Friedsam2000/Robotic-Arm-Prototype/README.md

Demo Video:

https://www.youtube.com/watch?v=VJjeDxEc2eg&ab_channel=Samuel
