Friedsam2000/Robotic-Arm-Prototype/Semester_Thesis_Tim_Heger_Final/100_Design_and_models/README.md

`100_Design_and_models` this folder is for models or CAD data
