Friedsam2000/Robotic-Arm-Prototype/Semester_Thesis_Tim_Heger_Final/900_Report/README.md

`900_Report`: folder with the LaTeX document for your final report

* You can compile and view the document using F5 / 'Compile and View' in TeXstudio
* See the actual template for examples and more details on how to use it
* `clean.bat` : deletes all auxiliary and temporary files (recursively); also deletes all pdf documents _in the current folder only_

Edit the `setup/metadata.tex` file to customise your name, thesis title, date etc.

Second-level structure:
* `images` store images and figures here
* `tikz` put your TikZ files in this folder
* `setup` here are the configuration files
* `chapters` here are the `*.tex` files of the report itself
* `auxfiles` auxiliary stuff is stored here
* `attachments` (optional) here are the attachments
* `sources` (optional) here are the sources of your listings
* `bibtex` put the BibTeX file here
