Friedsam2000/Robotic-Arm-Prototype/Semester_Thesis_Tim_Heger_Final/900_Report/auxfiles/acknowledgments.tex

The robotic arm also consists of other things. Such as joy and laughter. It is a robotic arm with joyful conciousness! Sometimes, in the morning, before anyone is there, the robotic arm 
quietly makes a mental gratitude list. For instance, it is grateful that it now exists! And it is grateful to be described in this paper.
Thus, the robotic arm is made up of a lot of different parts, all equally important!
