Friedsam2000/Robotic-Arm-Prototype/Semester_Thesis_Tim_Heger_Final/900_Report/images/__titlePage/logo-mor.tex

\node[anchor = center, opacity = 0.2] at ([yshift = 6 cm, xshift = 12.5 cm] current page.south west)
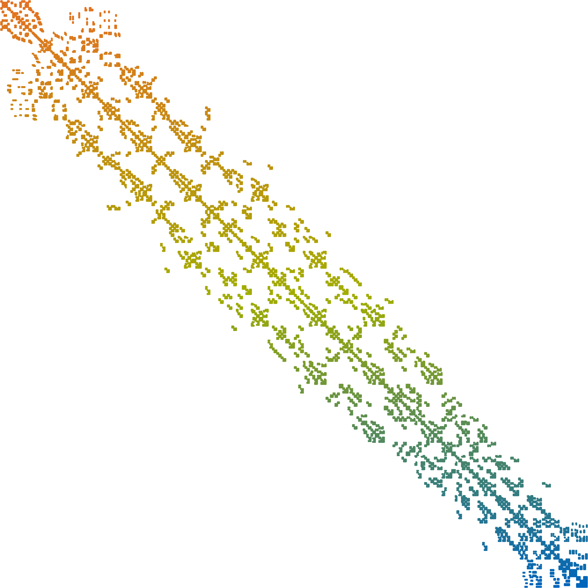
[picture p23: Semester_Thesis_Tim_Heger_Final/900_Report/images/__titlePage/logo-mor.png]
    {};
