Friedsam2000/Robotic-Arm-Prototype/Semester_Thesis_Tim_Heger_Final/900_Report/images/__titlePage/logo-mpc.tex

\node[anchor = center, opacity = 0.2] at ([yshift = 3 cm, xshift = 10.5 cm] current page.south west)
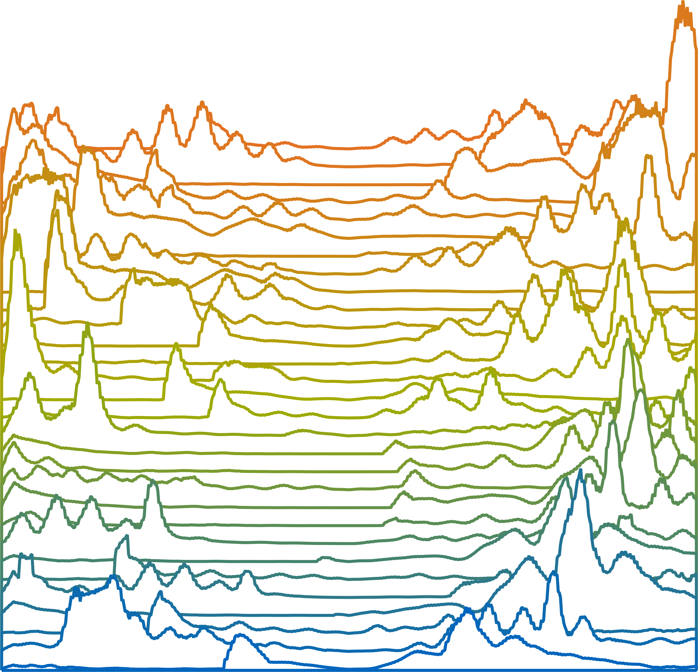
[picture p24: Semester_Thesis_Tim_Heger_Final/900_Report/images/__titlePage/logo-mpc.png]
    {};
