Friedsam2000/Robotic-Arm-Prototype/Semester_Thesis_Tim_Heger_Final/020_Presentations/main.pdf

Lehrstuhl für Regelungstechnik School of Engineering and Design Technische Universität München

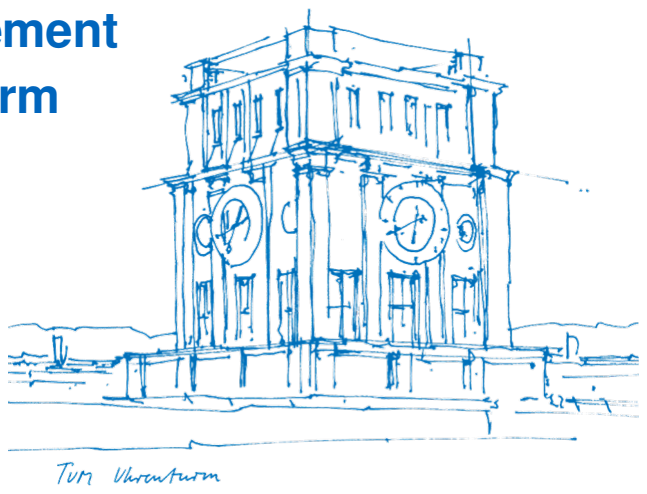
[picture p46: figure]

# Development and Enhancement of a Lightweight Robotic Arm

## with Torque Control Exploration

## Tim Heger

Lehrstuhl für Regelungstechnik School of Engineering and Design Technische Universität München

## 3. Dezember 2025

# Outline

1 | Einführung
2 | Hardware Verbesserungen
3 | Drehmomentmessung
4 | Drehmomentbasierte Regelung
Tim Heger | Development and Enhancementof a Lightweight Robotic Arm | 03/12/2025 | 1

# Einführung

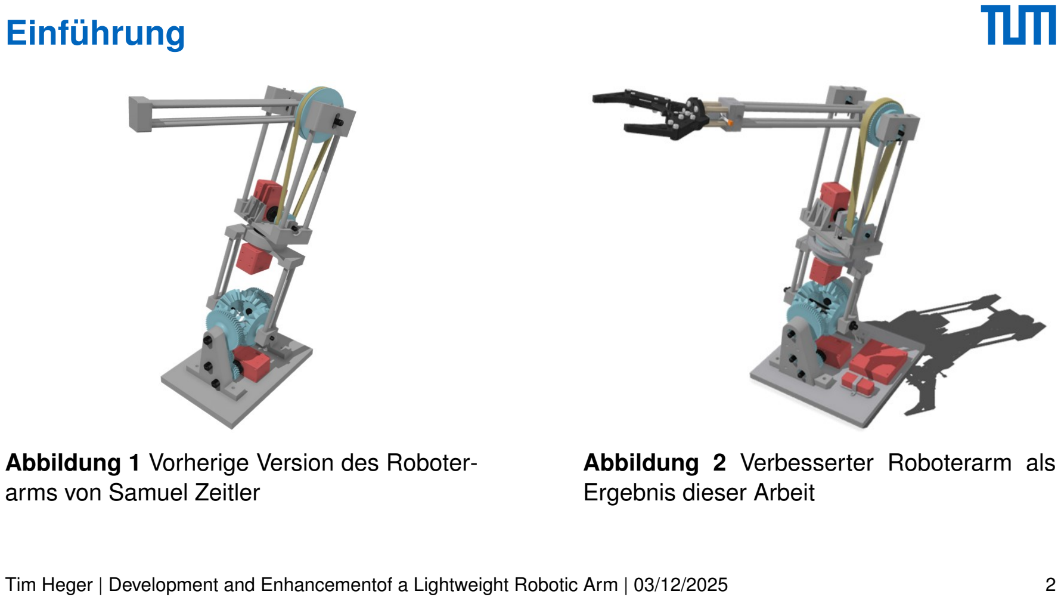
[picture p47: page 3]

### Abbildung 1 Vorherige Version des Roboterarms von Samuel Zeitler

### Abbildung 2 Verbesserter Roboterarm als Ergebnis dieser Arbeit

Tim Heger | Development and Enhancementof a Lightweight Robotic Arm | 03/12/2025 | 2

# Outline

1 | Einführung
2 | Hardware Verbesserungen
3 | Drehmomentmessung
4 | Drehmomentbasierte Regelung
Tim Heger | Development and Enhancementof a Lightweight Robotic Arm | 03/12/2025 | 2

# Hardware Verbesserungen

## Mechanische Verstärkungen

## ■ Achsen aus Aluminium gedreht

## ■ Kugellager hinzugefügt

## ■ Basis und Seitenstreben aus Aluminium gefräst


### Abbildung 3 Beispielhafte Ansicht der Hardwareverbesserungen am Schultergelenk

Tim Heger | Development and Enhancementof a Lightweight Robotic Arm | 03/12/2025 | 3

# Hardware Verbesserungen

## Planetengetriebe

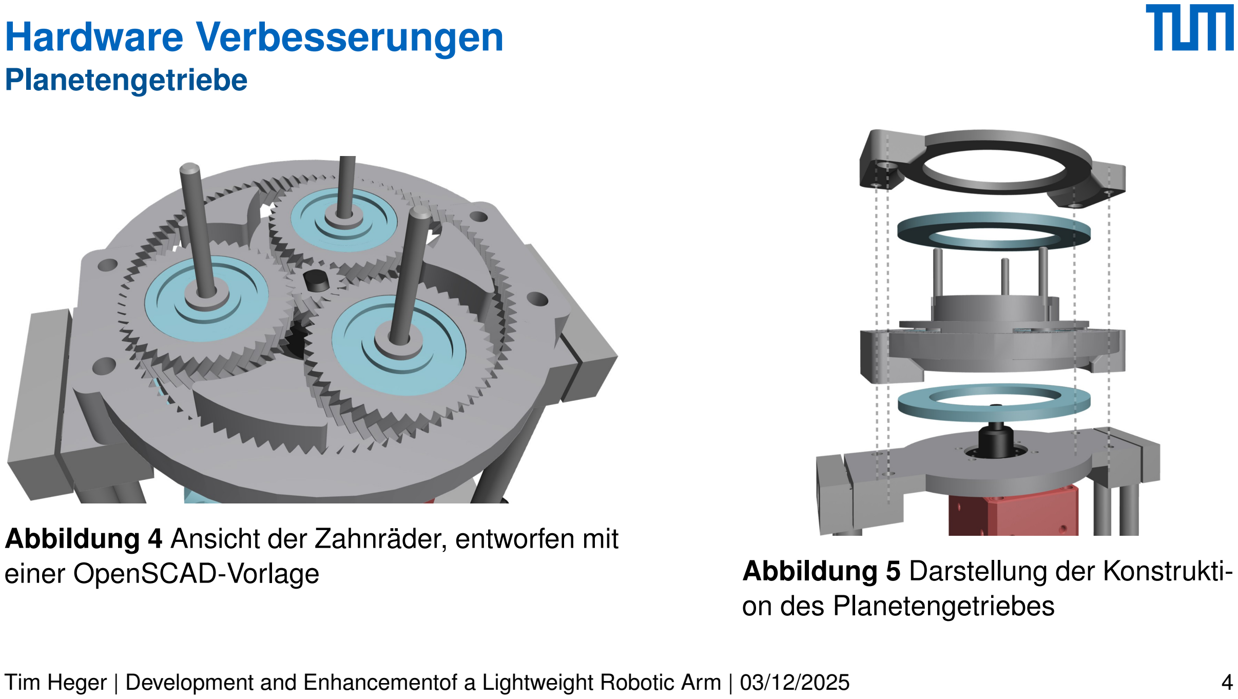
[picture p48: page 6]

### Abbildung 4 Ansicht der Zahnräder, entworfen mit

einer OpenSCAD-Vorlage | Abbildung 5 Darstellung der Konstrukti- on des Planetengetriebes
Tim Heger | Development and Enhancementof a Lightweight Robotic Arm | 03/12/2025 | 4

# Hardware Verbesserungen

## Endeffektor


### Abbildung 6 Greifhand mit zwei Fingern als Endeffektor

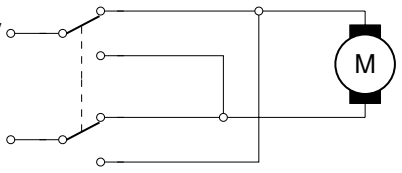
[picture p49: figure]

5V

## GND

### Abbildung 7 Shaltbild des Anschlusses der Greifhand

Tim Heger | Development and Enhancementof a Lightweight Robotic Arm | 03/12/2025 | 5

# Outline

1 | Einführung
2 | Hardware Verbesserungen
3 | Drehmomentmessung
4 | Drehmomentbasierte Regelung
Tim Heger | Development and Enhancementof a Lightweight Robotic Arm | 03/12/2025 | 5

# Drehmomentmessung

## Expreimentaufbau


### Abbildung 8 Experimentaufbau zur Drehmomentmessung der Motoren

Tim Heger | Development and Enhancementof a Lightweight Robotic Arm | 03/12/2025 | 6

# Drehmomentmessung

## Einteilung in drei Betriebsarten


Abbildung 9 Experiment zur Feststellung der drei Betriebsarten: Entgegenwirkender Moment, Still-

### stand, und mitwirkender Moment

Tim Heger | Development and Enhancementof a Lightweight Robotic Arm | 03/12/2025 | 7

# Drehmomentmessung

## Ergebnisse


Abbildung 10 Ergebnisse der Drehmomentmessung: zwei Kennlinien für die zwei dynamischen Be-

### triebsarten

Tim Heger | Development and Enhancementof a Lightweight Robotic Arm | 03/12/2025 | 8

# Drehmomentmessung

## Implementierung einer Kräftemessung

F = (J

T
)
+ τ | (1)

## Gesucht: Kraftvektor F Gegeben: Jacobi-Matrix J Gemessen: Drehmomentvektor der Gelenke τ

## Demonstration

Tim Heger | Development and Enhancementof a Lightweight Robotic Arm | 03/12/2025 | 9

# Outline

1 | Einführung
2 | Hardware Verbesserungen
3 | Drehmomentmessung
4 | Drehmomentbasierte Regelung
Tim Heger | Development and Enhancementof a Lightweight Robotic Arm | 03/12/2025 | 9

# Drehmomentbasierte Regelung

## PD-Regler im Gelenkraum

τtarget = −Kp ∆q − Kd q˙current | (2)

## Gesucht: Drehmomentvektor der Gelenke τtarget Gegeben: Proportional- und Differentialverstärkung Kp und Kd Gemessen: Gelenkpositionsfehler ∆q und Gelenkgeschwindigkeitsvektor q˙current

## Demonstration

Tim Heger | Development and Enhancementof a Lightweight Robotic Arm | 03/12/2025 | 10

# Drehmomentbasierte Regelung

## PD-Regler im Kartesischen Raum

Ftarget = −Kp ∆x − Kd

xcurrent − xprevious
∆t
| | {z | }
| x˙

(3)

τtarget = J

T Ftarget
| | {z | }
τtask

+ knull N

∂H
∂q
| | {z | }
τnull

(4)

## Gesucht: Drehmomentvektor der Gelenke τtarget Gegeben: Kp und Kd, Jacobi-Matrix J, Nullraumverstärkung knull Errechnet: Nullraumprojektion N und Kostenfunktion ∂H

∂q

## Gemessen: TCP-Positionen ∆x, xcurrent und xprevious, zeitintervall ∆t

Tim Heger | Development and Enhancementof a Lightweight Robotic Arm | 03/12/2025 | 11

# Drehmomentbasierte Regelung

## Krafterzeugung

Ftarget = Fpd + Fdes | (5)
Fpd = −Kp ∆xline − Kd ∆ ˙xline | (6)

## Gesucht: TCP-Kräfte Ftarget Gegeben: Kp und Kd, zu erzeugende Kraft Fdes Errechnet: Distanz zur durch Ftarget aufgespannten Linie ∆xline und ∆ ˙xline Gemessen: TCP-Positionen zur Berechnung von ∆xline und ∆ ˙xline

## Demonstration

Tim Heger | Development and Enhancementof a Lightweight Robotic Arm | 03/12/2025 | 12

# Vielen Dank für Ihre Aufmerksamkeit!

# Haben Sie noch Fragen? Oder Anregungen für zukünftige Arbeiten?

Tim Heger | Development and Enhancementof a Lightweight Robotic Arm | 03/12/2025 | 13

# Anhang

## Berechnung der Nullraumprojektion und Kostenfunktion

## N = I − J

T

## J JT + λ

2
damp I

−1
J | (7)

## Gesucht: Nullraumprojektion N Gegeben: Dämpfungsfaktor λdamp, Einheitsmatrix I, Jacobi-Matrix J

∂H

## ∂q = diag

1
q

2
max

| | {z | }
Gewichtsmatrix W
(q − qdes) | (8)

## Gesucht: Ableitung der Kostenfunktion ∂H

∂q

## Gegeben: gewünschte Gelenkposition qdes, maximale Gelenkposition qmax Gemessen: aktuelle Gelenkposition q

Tim Heger | Development and Enhancementof a Lightweight Robotic Arm | 03/12/2025 | 14

# Anhang

## Berechnung der Distanz zur Kraftlinie

∆xline = ∆x −

(∆x · Fdes)

## norm(Fdes)

2

- Fdes | (9)

∆ ˙xline =

∆xline,curr − ∆xline,prev
∆t

(10)

## Gesucht: Distanz zur Kraftlinie ∆xline und ∆ ˙xline Gegeben: gewünschte Kraft Fdes Gemessen: TCP-Positionen zur Berechnung von ∆x, Zeitintervall ∆t

Tim Heger | Development and Enhancementof a Lightweight Robotic Arm | 03/12/2025 | 15
