Friedsam2000/Robotic-Arm-Prototype/Semester_Thesis_Tim_Heger_Final/900_Report/auxfiles/__backMatter.tex

% ==================================================================
% Appendices and back matter
% ==================================================================
\appendix

\include{auxfiles/notation}

\renewcommand{\listtheoremname}{\nameLoTheorems}
\listoftheorems
\addcontentsline{toc}{chapter}{\nameLoTheorems}

\renewcommand{\listalgorithmcfname}{\nameLoAlgorithms}
\listofalgorithms
\addcontentsline{toc}{chapter}{\nameLoAlgorithms}

\renewcommand{\listfigurename}{\nameLoFigures}
\listoffigures
\addcontentsline{toc}{chapter}{\nameLoFigures}

\renewcommand{\listtablename}{\nameLoTables}
\listoftables
\addcontentsline{toc}{chapter}{\nameLoTables}

\renewcommand{\lstlistlistingname}{\nameLoListings}
\lstlistoflistings
\addcontentsline{toc}{chapter}{\nameLoListings}

\printbibliography[title=\nameCaReferences]
\addcontentsline{toc}{chapter}{\nameCaReferences}

% ==================================================================
