Friedsam2000/Robotic-Arm-Prototype/Semester_Thesis_Tim_Heger_Final/900_Report/auxfiles/abbreviationsAndAcronyms.tex

% ======================================================================
% Declare acronyms
% ======================================================================
\DeclareAcronym{LQR}{
  short = LQR,
  long = linear quadratic regulator
}

\DeclareAcronym{LMS}{
  short = LMS,
  long = least mean squares
}

\DeclareAcronym{MPC}{
  short = MPC,
  long = model predictive control
}

\DeclareAcronym{MSE}{
  short = MSE,
  long = mean-square error
}

\DeclareAcronym{DAE}{
  short = DAE,
  long = differential algebraic equation
}

\DeclareAcronym{ODE}{
  short = ODE,
  long = ordinary differential equation
}

\DeclareAcronym{PDE}{
  short = PDE,
  long = partial differential equation
}

\DeclareAcronym{EKF}{
  short = EKF,
  long = extended Kalman filter
}

\DeclareAcronym{LP}{
  short = LP,
  long = linear program
}

\DeclareAcronym{MHE}{
  short = MHE,
  long = moving horizon estimation
}

\DeclareAcronym{MRAC}{
  short = MRAC,
  long = model reference adaptive control
}

\DeclareAcronym{NMPC}{
  short = NMPC,
  long = nonlinear model predictive control
}

\DeclareAcronym{OCP}{
  short = OCP,
  long = optimal control problem
}

\DeclareAcronym{QP}{
  short = QP,
  long = quadratic program
}

\DeclareAcronym{RHC}{
  short = RHC,
  long = receding horizon control
}

\DeclareAcronym{SDP}{
  short = SDP,
  long = semidefinite programming
}
% ======================================================================
