Friedsam2000/Robotic-Arm-Prototype/Semester_Thesis_Tim_Heger_Final/900_Report/auxfiles/abstractDE.tex

Bitte hier die Kurzfassung auf Deutsch hinzufügen:
\verb|./auxfiles/abstractDE.tex|
