Friedsam2000/Robotic-Arm-Prototype/Semester_Thesis_Tim_Heger_Final/100_Design_and_models/visualisation/planetary_gearbox_explosion.png

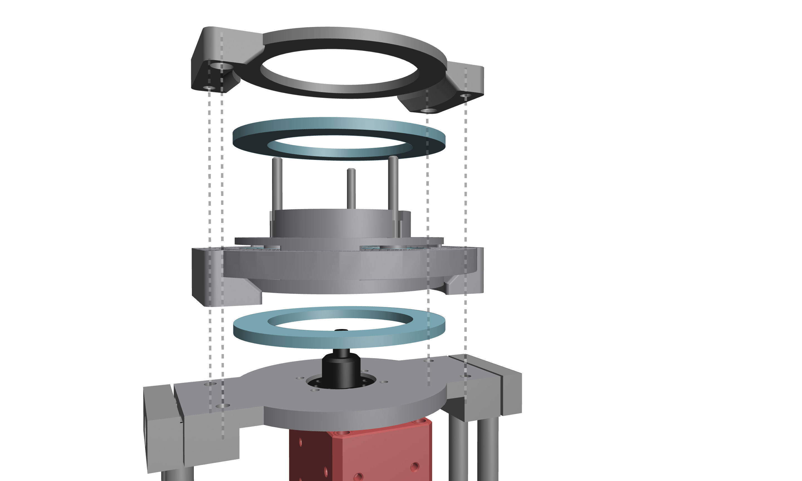
Semester_Thesis_Tim_Heger_Final/100_Design_and_models/visualisation/planetary_gearbox_explosion.png
