Friedsam2000/Robotic-Arm-Prototype/Semester_Thesis_Tim_Heger_Final/100_Design_and_models/visualisation/robot_arm_final.png

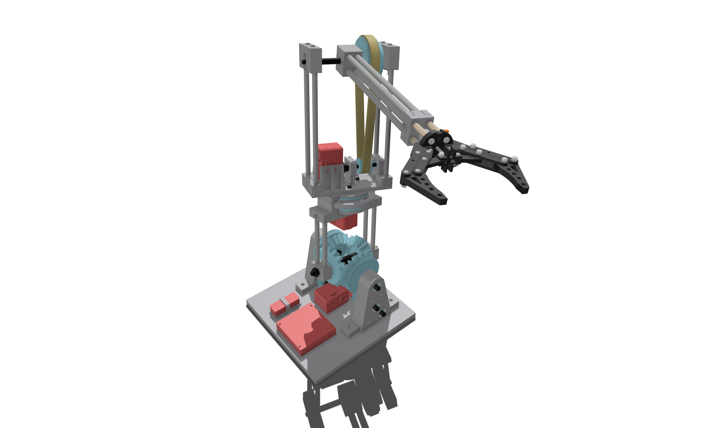
Semester_Thesis_Tim_Heger_Final/100_Design_and_models/visualisation/robot_arm_final.png
