Friedsam2000/Robotic-Arm-Prototype/Semester_Thesis_Tim_Heger_Final/900_Report/images/robot_arm_final_v3.jpg

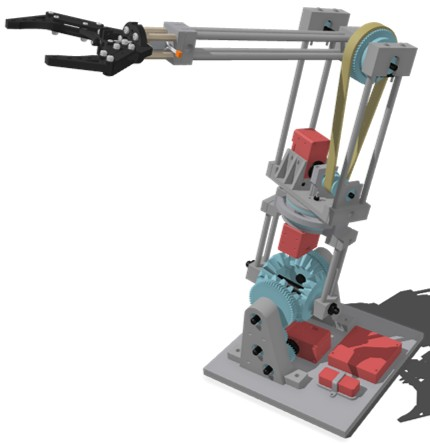
Semester_Thesis_Tim_Heger_Final/900_Report/images/robot_arm_final_v3.jpg
