Friedsam2000/Robotic-Arm-Prototype/UML_Diagram/UML_Diagram.png

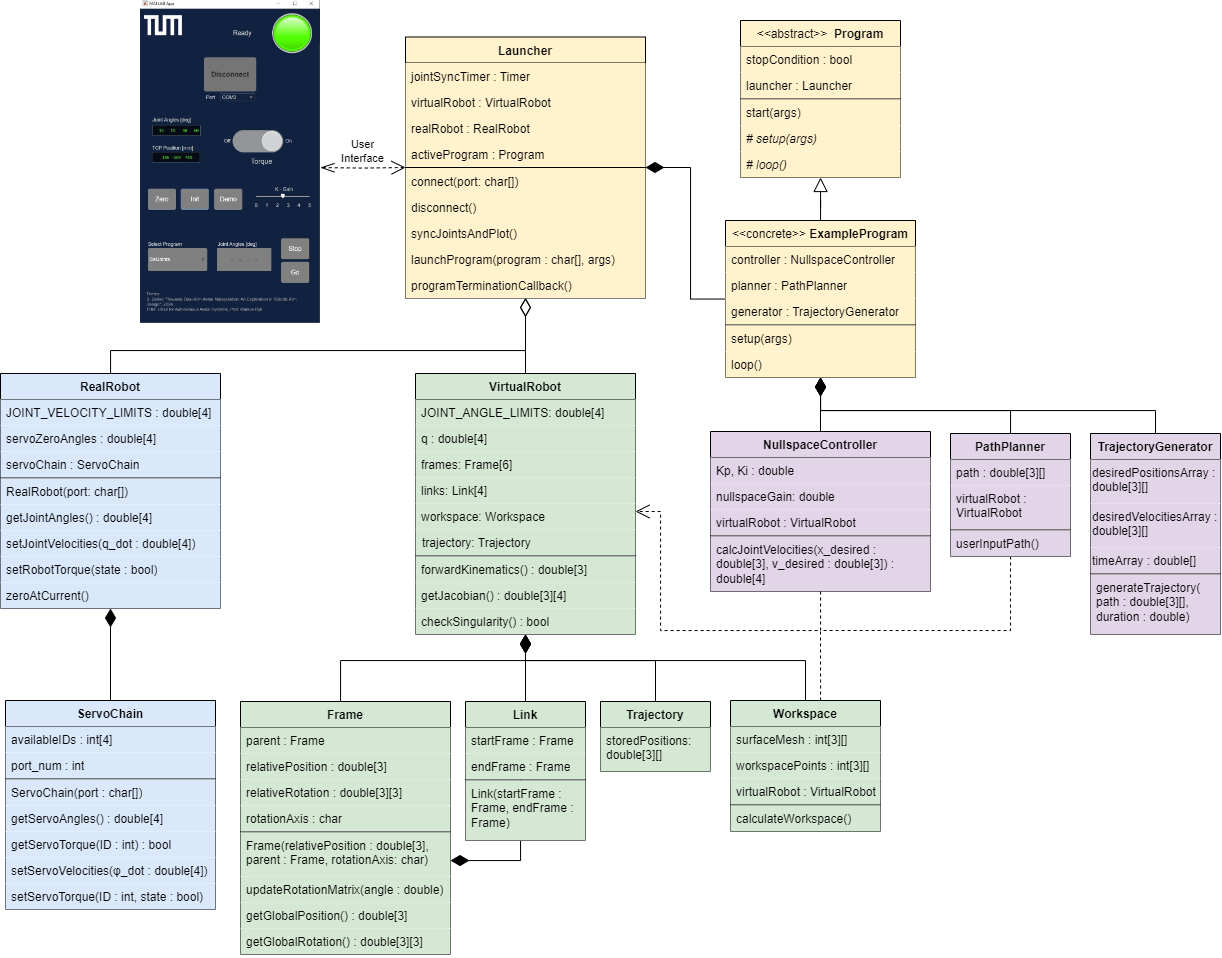
UML_Diagram/UML_Diagram.png
