Friedsam2000/Robotic-Arm-Prototype/Semester_Thesis_Tim_Heger_Final/100_Design_and_models/upper_segment/printing/_part_list.txt

1x upper_segment_base
2x upper_segment_base_clamp
2x ball_bearing_brace
2x tentioner_tube
2x tensioner_tube_holder
1x tube_endeffector1
1x tube_endeffector2
1x endeffector_plate
1x endeffector_brace1
1x endeffector_brace2
