Friedsam2000/Robotic-Arm-Prototype/Master_Thesis_Samuel_Zeitler_Final/CAD/shoulder_parts/turning/_part_list.txt

bevel_shaft x1
middle_shaft x2
motor_shaft x2
top_shaft x2
