Friedsam2000/Robotic-Arm-Prototype/Semester_Thesis_Tim_Heger_Final/100_Design_and_models/lower_segment/print2-turning/printing/_part_list.txt

connector_brace x1
connector_brace_tubes x2
gear_ring_v2 x1
gearbox_lid x1
planetary_axis_top x1
side_brace_torque_wheel x1
sun_gear_v2 x1
