Friedsam2000/Robotic-Arm-Prototype/Master_Thesis_Samuel_Zeitler_Final/CAD/shoulder_parts/printing/spacing_ring_bevel.stl

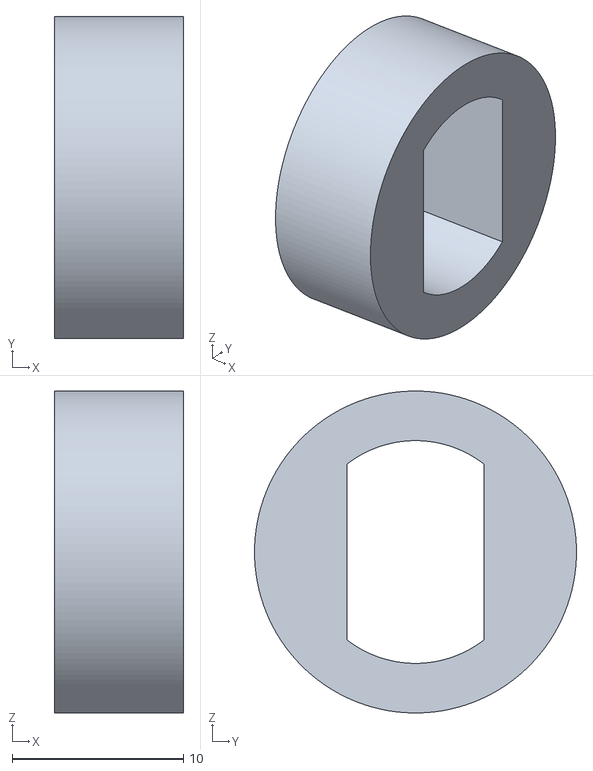
[picture p57: CAD file, 2025-12-09]
Master_Thesis_Samuel_Zeitler_Final/CAD/shoulder_parts/printing/spacing_ring_bevel.stl
7.53 x 18.8 x 18.8
