Friedsam2000/Robotic-Arm-Prototype/Master_Thesis_Samuel_Zeitler_Final/CAD/shoulder_parts/turning/middle_shaft.step

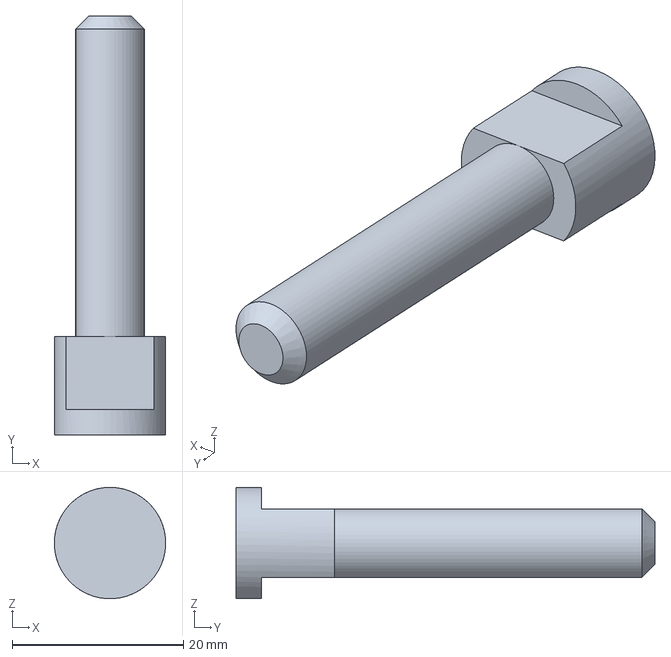
[picture p58: CAD file, 2025-05-21]
Master_Thesis_Samuel_Zeitler_Final/CAD/shoulder_parts/turning/middle_shaft.step
13.0 x 48.9 x 13.0 mm
