Friedsam2000/Robotic-Arm-Prototype/Semester_Thesis_Tim_Heger_Final/100_Design_and_models/ground_segment/milling/Side_Brace.step

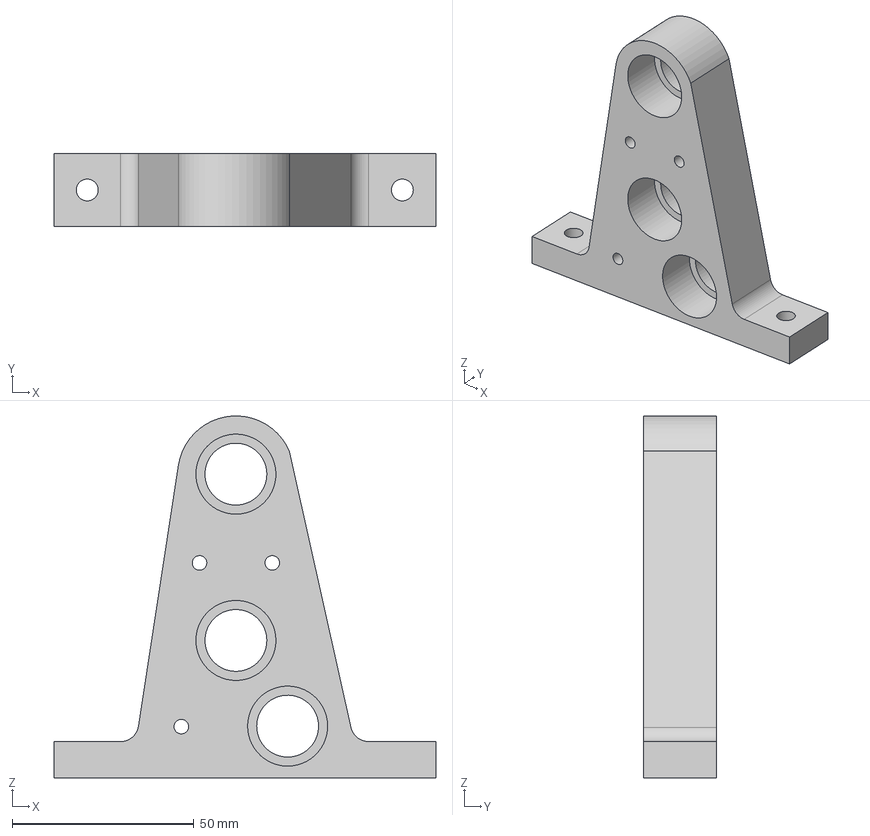
[picture p59: CAD file, 2025-12-09]
Semester_Thesis_Tim_Heger_Final/100_Design_and_models/ground_segment/milling/Side_Brace.step
105.0 x 20.0 x 99.5 mm
