Friedsam2000/Robotic-Arm-Prototype/Semester_Thesis_Tim_Heger_Final/100_Design_and_models/ground_segment/printing/torque_wheel.stl

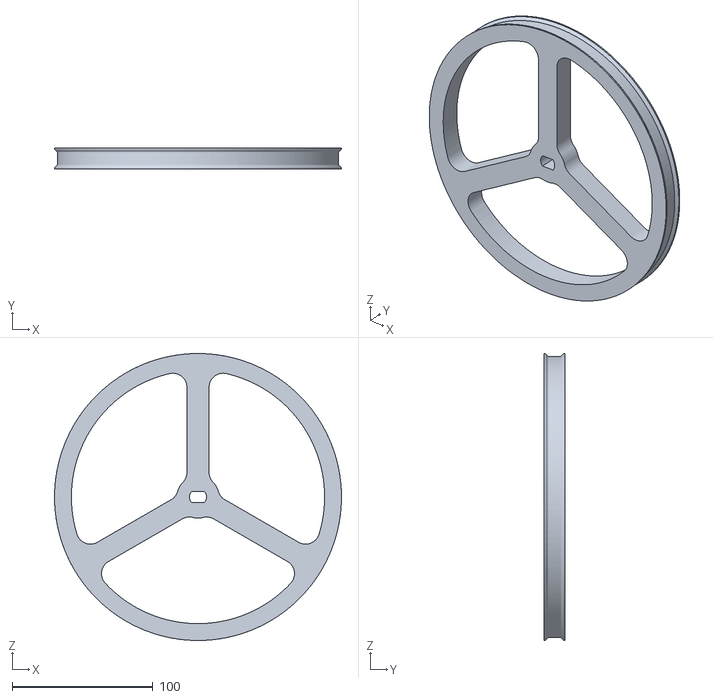
[picture p60: CAD file, 2025-12-09]
Semester_Thesis_Tim_Heger_Final/100_Design_and_models/ground_segment/printing/torque_wheel.stl
204.0 x 15.0 x 204.0
