Friedsam2000/Robotic-Arm-Prototype/Semester_Thesis_Tim_Heger_Final/100_Design_and_models/ground_segment/turning/top_shaft.step

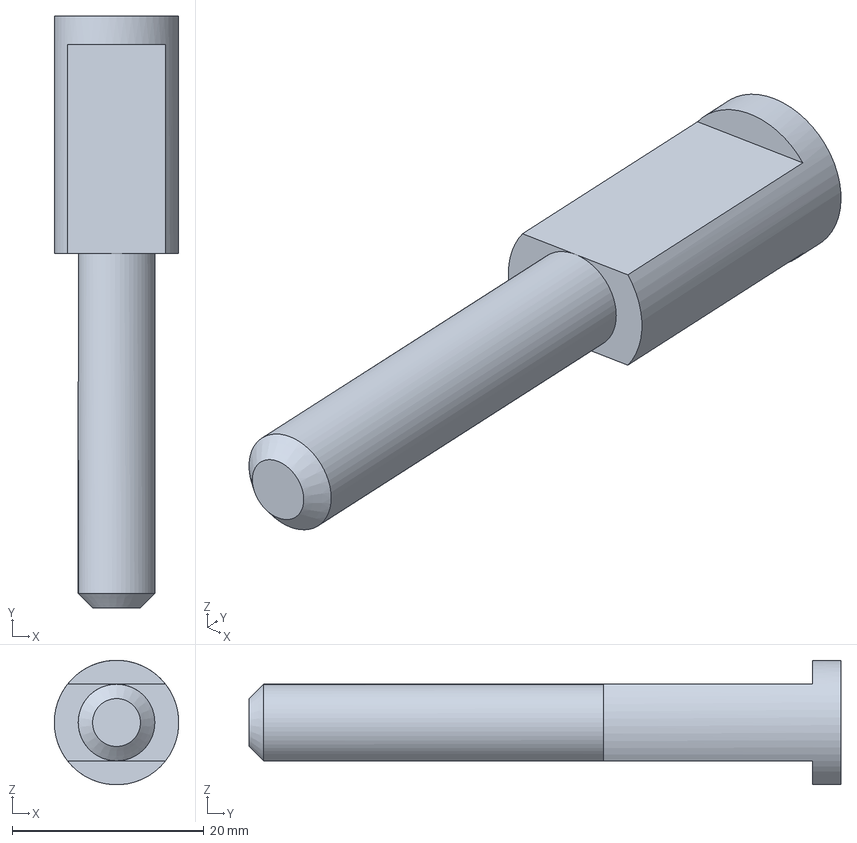
[picture p61: CAD file, 2025-05-21]
Semester_Thesis_Tim_Heger_Final/100_Design_and_models/ground_segment/turning/top_shaft.step
13.0 x 61.8 x 13.0 mm
