Friedsam2000/Robotic-Arm-Prototype/Semester_Thesis_Tim_Heger_Final/100_Design_and_models/lower_segment/print1/sun_gear.stl

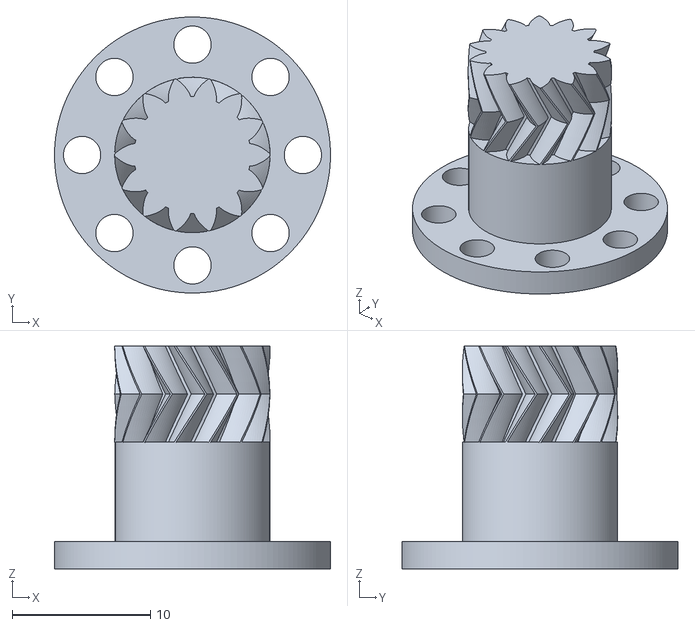
[picture p62: CAD file, 2025-12-09]
Semester_Thesis_Tim_Heger_Final/100_Design_and_models/lower_segment/print1/sun_gear.stl
20.0 x 20.0 x 16.2
