Friedsam2000/Robotic-Arm-Prototype/Semester_Thesis_Tim_Heger_Final/100_Design_and_models/lower_segment/print2-turning/printing/connector_brace.stl

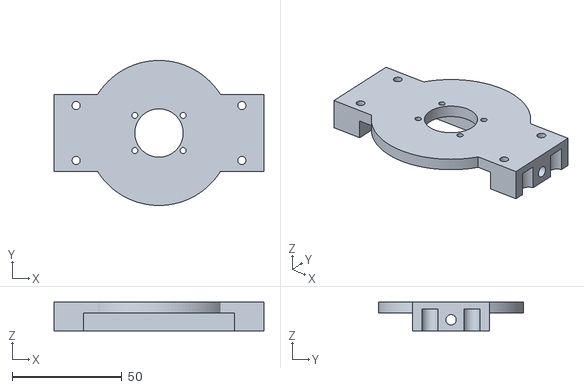
[picture p63: CAD file, 2025-12-09]
Semester_Thesis_Tim_Heger_Final/100_Design_and_models/lower_segment/print2-turning/printing/connector_brace.stl
95.6 x 66.0 x 13.0
