Friedsam2000/Robotic-Arm-Prototype/Semester_Thesis_Tim_Heger_Final/100_Design_and_models/lower_segment/print2-turning/turning/Motor_Axis.step

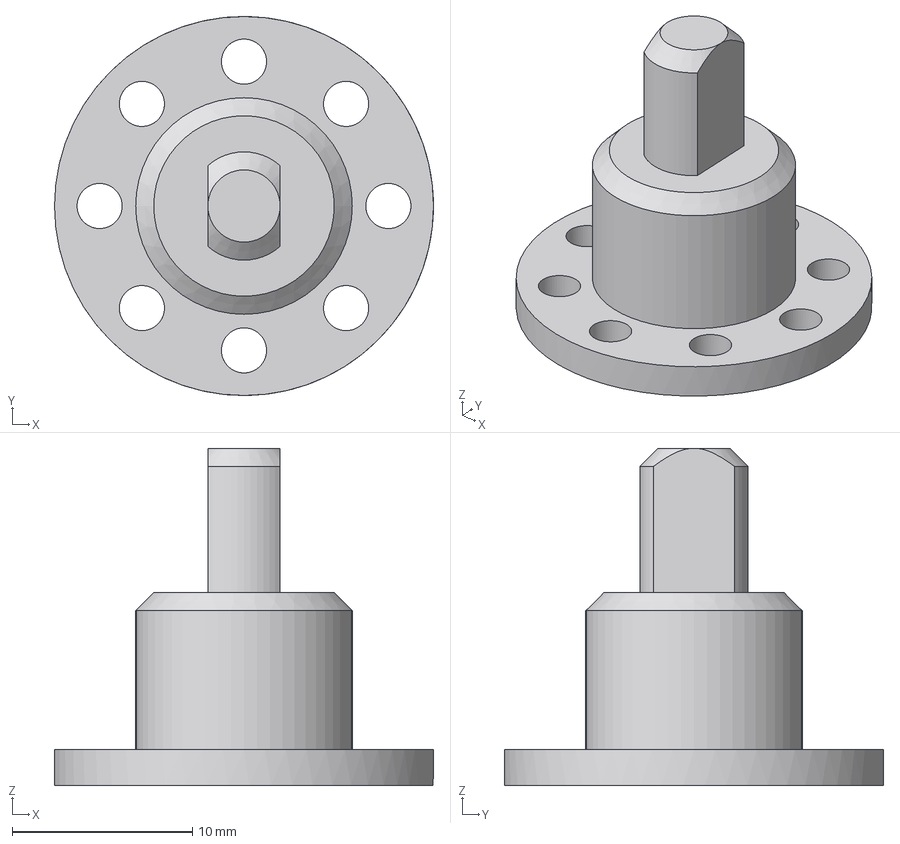
[picture p64: CAD file, 2025-12-09]
Semester_Thesis_Tim_Heger_Final/100_Design_and_models/lower_segment/print2-turning/turning/Motor_Axis.step
21.0 x 21.0 x 18.7 mm
