Friedsam2000/Robotic-Arm-Prototype/Semester_Thesis_Tim_Heger_Final/100_Design_and_models/lower_segment/print3-milling/Base_Plate.step

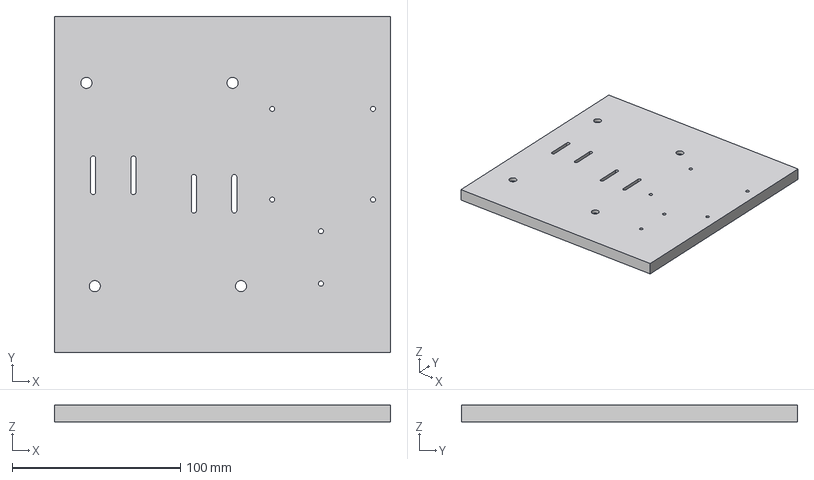
[picture p65: CAD file, 2025-12-09]
Semester_Thesis_Tim_Heger_Final/100_Design_and_models/lower_segment/print3-milling/Base_Plate.step
200.0 x 200.0 x 10.0 mm
