Friedsam2000/Robotic-Arm-Prototype/Semester_Thesis_Tim_Heger_Final/100_Design_and_models/lower_segment/print3-milling/printing/bevel_mount_fixed.stl

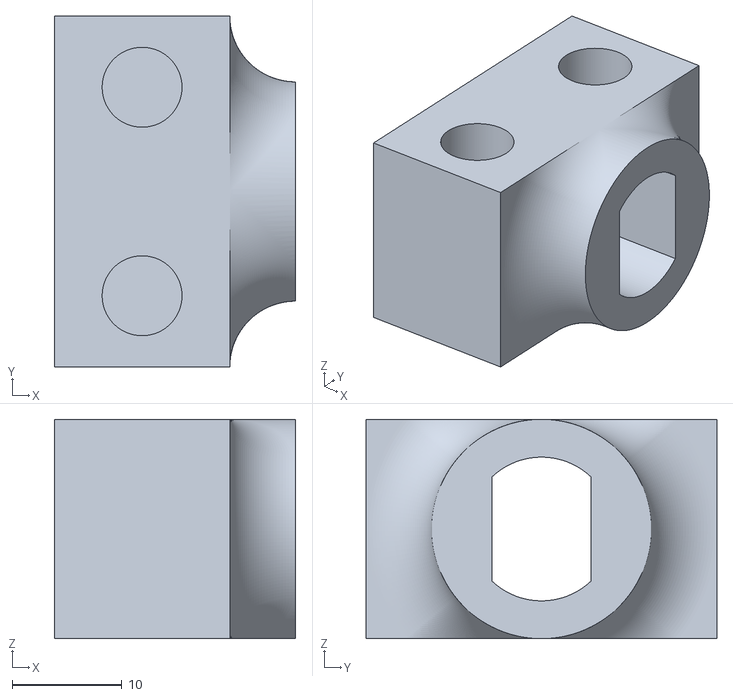
[picture p66: CAD file, 2025-12-09]
Semester_Thesis_Tim_Heger_Final/100_Design_and_models/lower_segment/print3-milling/printing/bevel_mount_fixed.stl
22.0 x 32.0 x 20.0
