Friedsam2000/Robotic-Arm-Prototype/Semester_Thesis_Tim_Heger_Final/100_Design_and_models/lower_segment/print4/bevel_mount_fixed_v4.stl

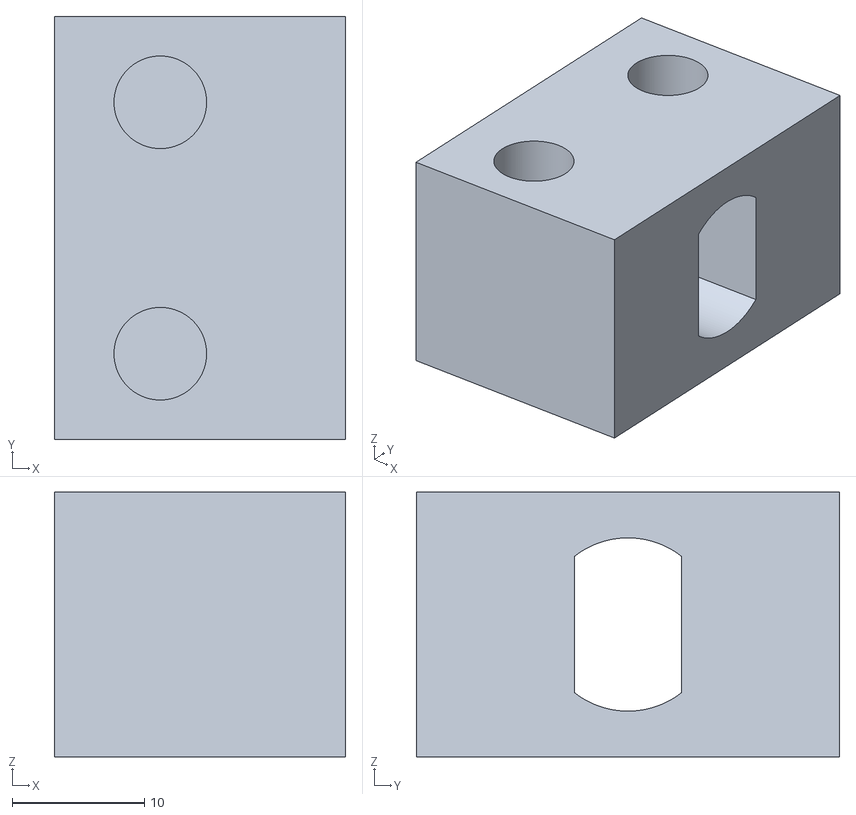
[picture p67: CAD file, 2025-12-09]
Semester_Thesis_Tim_Heger_Final/100_Design_and_models/lower_segment/print4/bevel_mount_fixed_v4.stl
22.0 x 32.0 x 20.0
