Friedsam2000/Robotic-Arm-Prototype/Semester_Thesis_Tim_Heger_Final/100_Design_and_models/upper_segment/printing/tube_endeffector1.stl

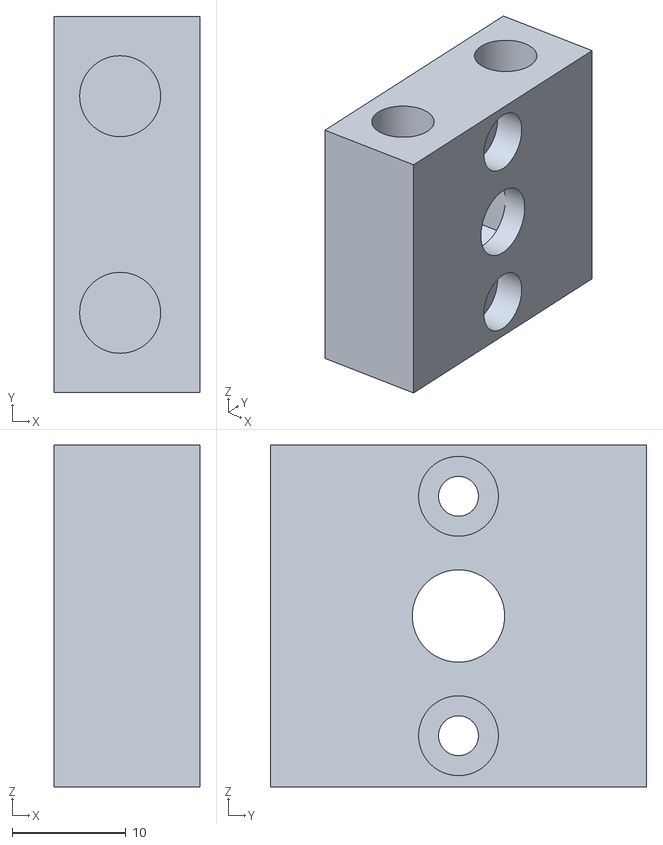
[picture p68: CAD file, 2025-12-09]
Semester_Thesis_Tim_Heger_Final/100_Design_and_models/upper_segment/printing/tube_endeffector1.stl
12.8 x 33.0 x 30.0
