Friedsam2000/Robotic-Arm-Prototype/Master_Thesis_Samuel_Zeitler_Final/CAD/shoulder_parts/printing/gear_top.stl

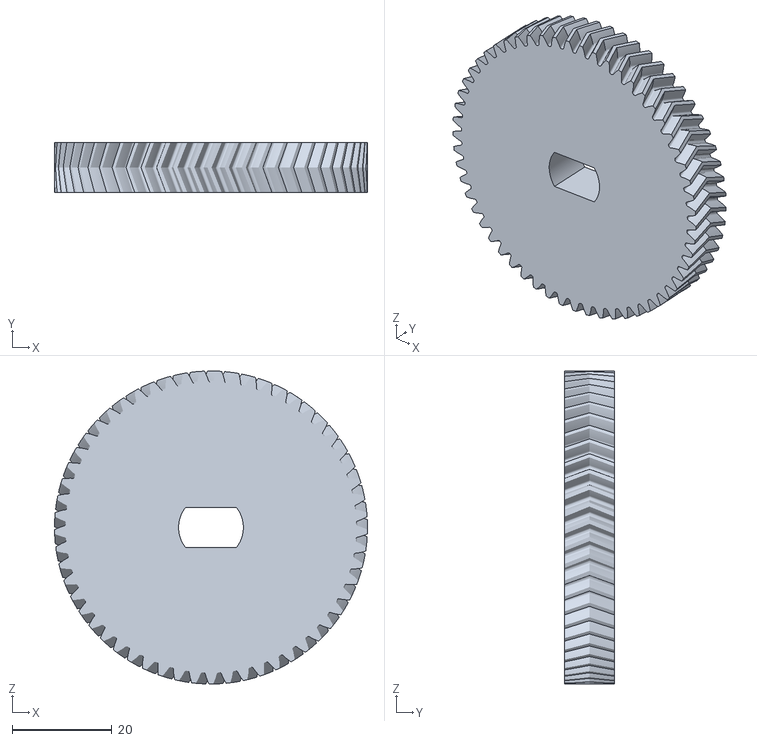
[picture p69: CAD file, 2025-12-09]
Master_Thesis_Samuel_Zeitler_Final/CAD/shoulder_parts/printing/gear_top.stl
62.8 x 10.0 x 62.8
