Friedsam2000/Robotic-Arm-Prototype/Master_Thesis_Samuel_Zeitler_Final/CAD/shoulder_parts/turning/bevel_shaft.step

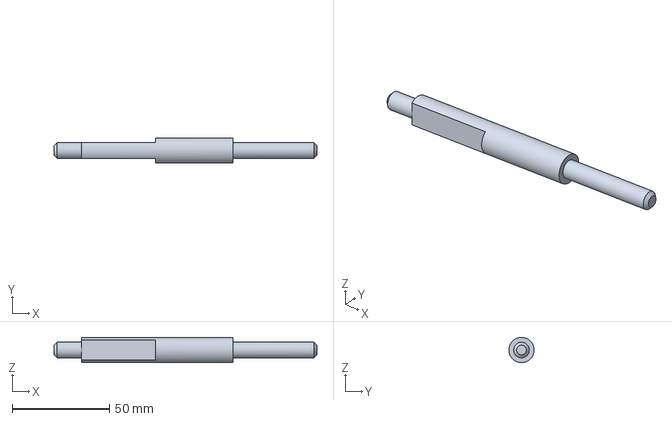
[picture p70: CAD file, 2025-05-21]
Master_Thesis_Samuel_Zeitler_Final/CAD/shoulder_parts/turning/bevel_shaft.step
135.0 x 13.0 x 13.0 mm
