Friedsam2000/Robotic-Arm-Prototype/Semester_Thesis_Tim_Heger_Final/100_Design_and_models/ground_segment/milling/Side_Lid.step

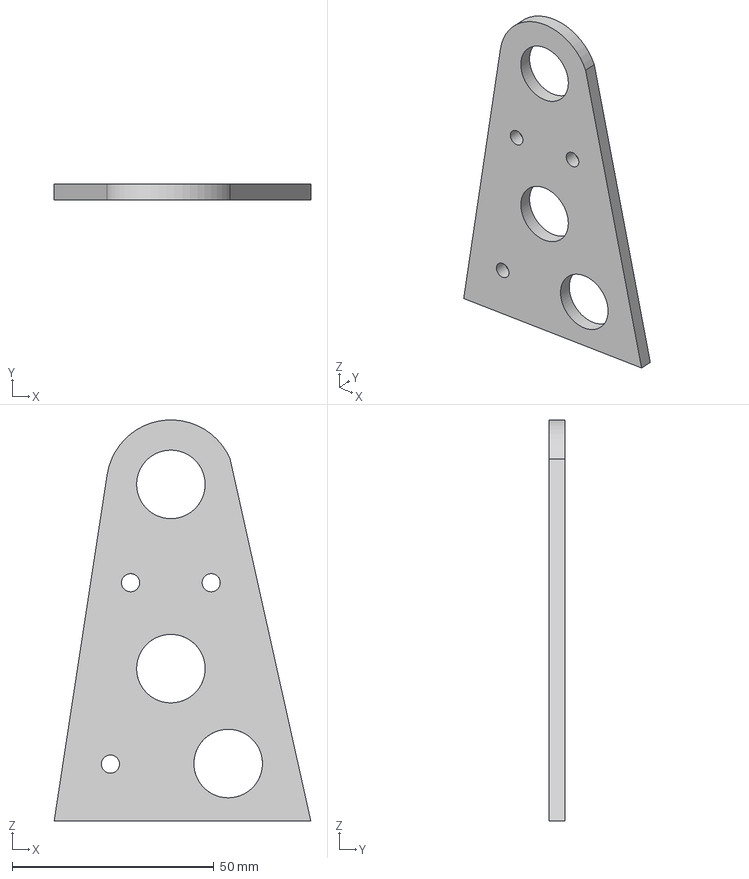
[picture p71: CAD file, 2025-12-09]
Semester_Thesis_Tim_Heger_Final/100_Design_and_models/ground_segment/milling/Side_Lid.step
63.7 x 4.00 x 99.5 mm
