Friedsam2000/Robotic-Arm-Prototype/Semester_Thesis_Tim_Heger_Final/100_Design_and_models/ground_segment/printing/gear_middle.stl

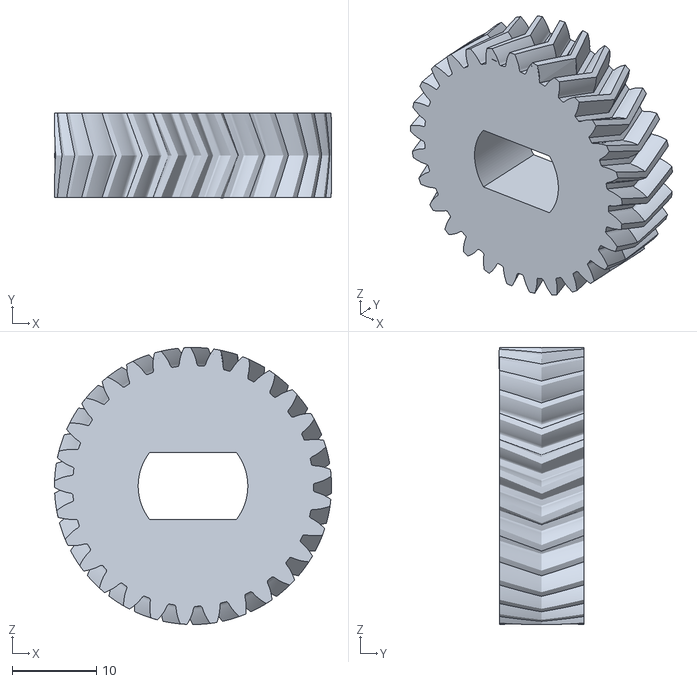
[picture p72: CAD file, 2025-12-09]
Semester_Thesis_Tim_Heger_Final/100_Design_and_models/ground_segment/printing/gear_middle.stl
32.9 x 10.0 x 32.9
