Friedsam2000/Robotic-Arm-Prototype/Semester_Thesis_Tim_Heger_Final/100_Design_and_models/lower_segment/planetary_gear/planetary_gearbox_v2.stl

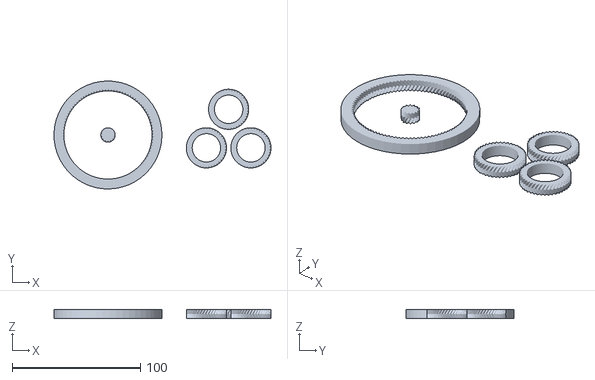
[picture p73: CAD file, 2025-12-09]
Semester_Thesis_Tim_Heger_Final/100_Design_and_models/lower_segment/planetary_gear/planetary_gearbox_v2.stl
169.4 x 84.2 x 7.00
