Friedsam2000/Robotic-Arm-Prototype/Semester_Thesis_Tim_Heger_Final/100_Design_and_models/lower_segment/print1/planetary_axis_base.stl

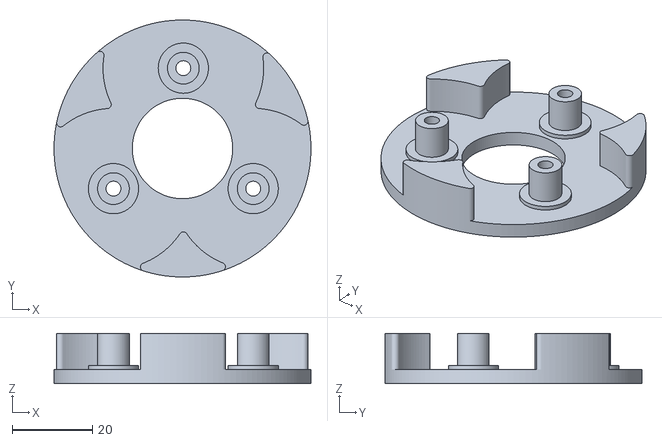
[picture p74: CAD file, 2025-12-09]
Semester_Thesis_Tim_Heger_Final/100_Design_and_models/lower_segment/print1/planetary_axis_base.stl
64.0 x 64.0 x 12.5
