Friedsam2000/Robotic-Arm-Prototype/Semester_Thesis_Tim_Heger_Final/100_Design_and_models/lower_segment/print2-turning/printing/planetary_axis_top.stl

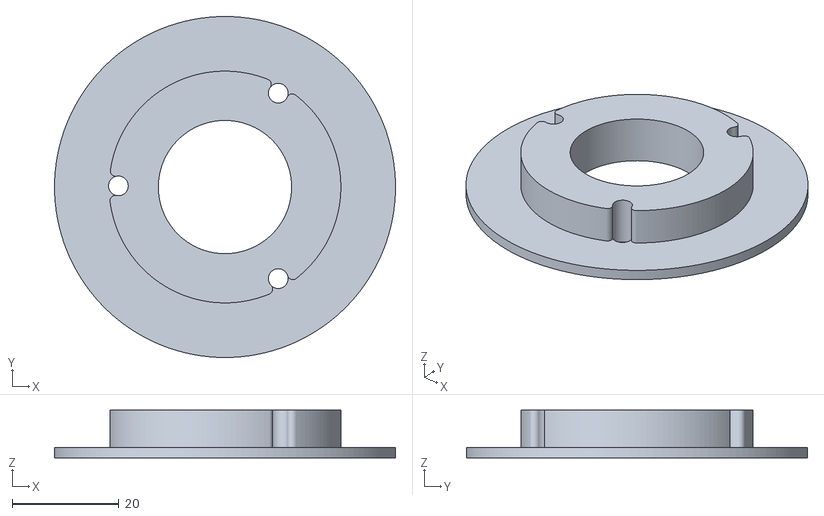
[picture p75: CAD file, 2025-12-09]
Semester_Thesis_Tim_Heger_Final/100_Design_and_models/lower_segment/print2-turning/printing/planetary_axis_top.stl
64.0 x 64.0 x 9.00
