Friedsam2000/Robotic-Arm-Prototype/Semester_Thesis_Tim_Heger_Final/100_Design_and_models/lower_segment/print2-turning/turning/motor_shaft.step

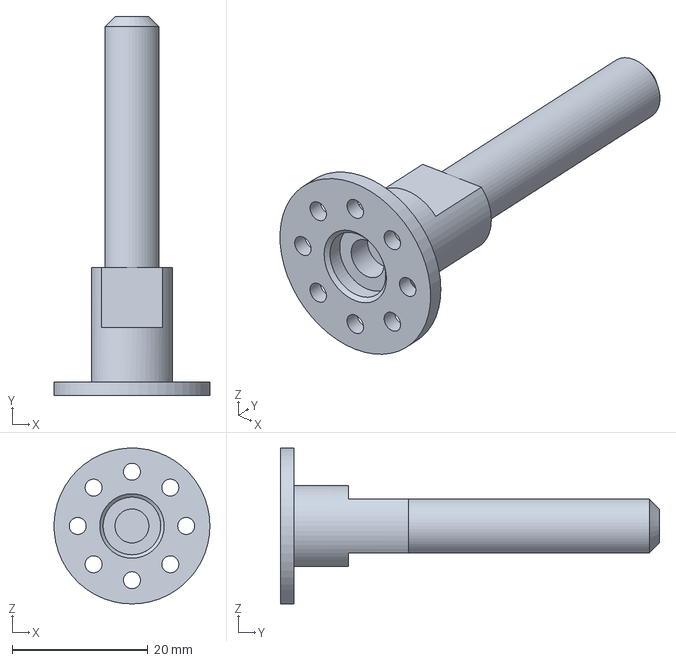
[picture p76: CAD file, 2025-05-21]
Semester_Thesis_Tim_Heger_Final/100_Design_and_models/lower_segment/print2-turning/turning/motor_shaft.step
23.0 x 55.9 x 23.0 mm
