Friedsam2000/Robotic-Arm-Prototype/Semester_Thesis_Tim_Heger_Final/100_Design_and_models/lower_segment/print4/bevel_mount_v3.stl

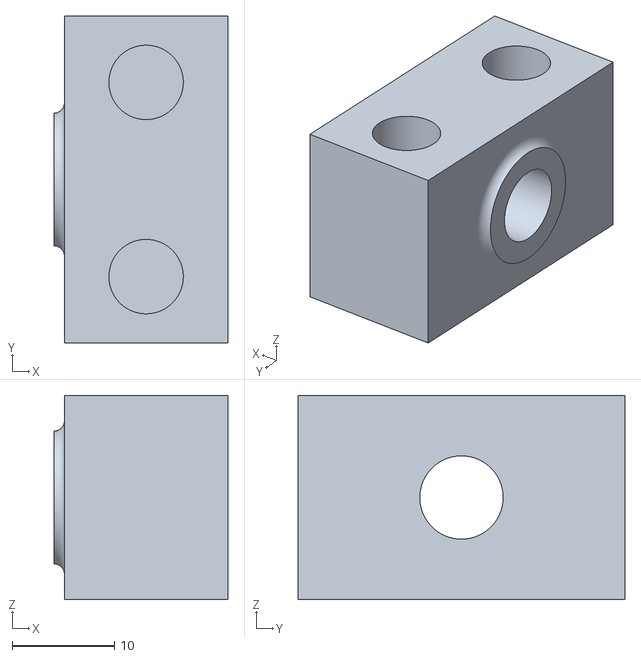
[picture p78: CAD file, 2025-12-09]
Semester_Thesis_Tim_Heger_Final/100_Design_and_models/lower_segment/print4/bevel_mount_v3.stl
17.0 x 32.0 x 20.0
