Friedsam2000/Robotic-Arm-Prototype/Semester_Thesis_Tim_Heger_Final/100_Design_and_models/upper_segment/printing/endeffector_brace1.stl

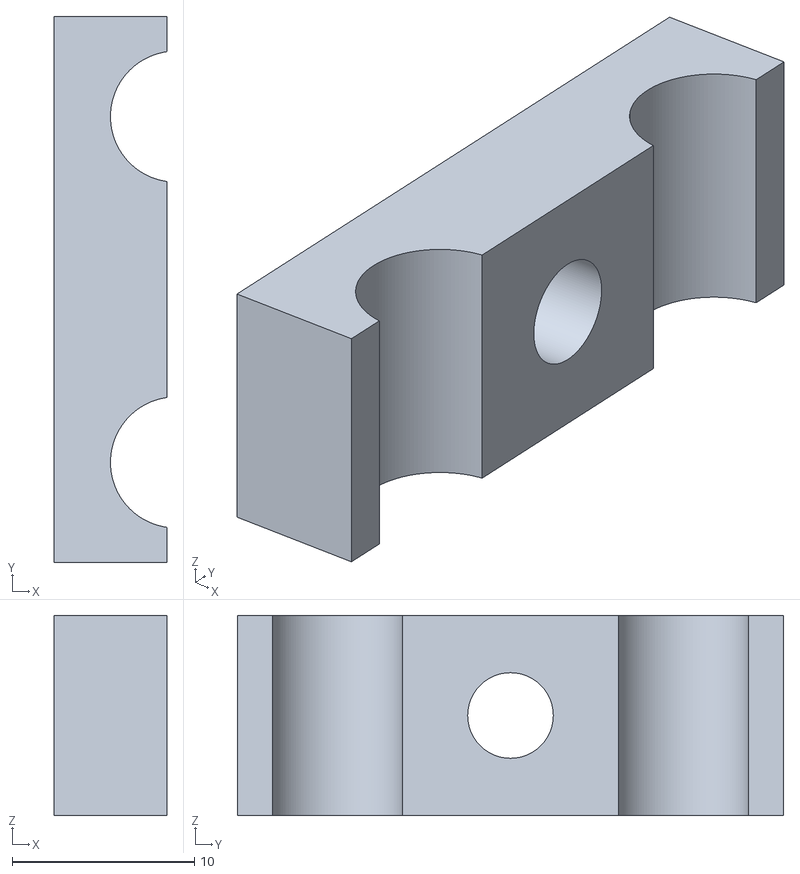
[picture p79: CAD file, 2025-12-09]
Semester_Thesis_Tim_Heger_Final/100_Design_and_models/upper_segment/printing/endeffector_brace1.stl
6.20 x 30.0 x 11.0
