Friedsam2000/Robotic-Arm-Prototype/Semester_Thesis_Tim_Heger_Final/100_Design_and_models/lower_segment/print2-turning/printing/gear_ring_v2.stl

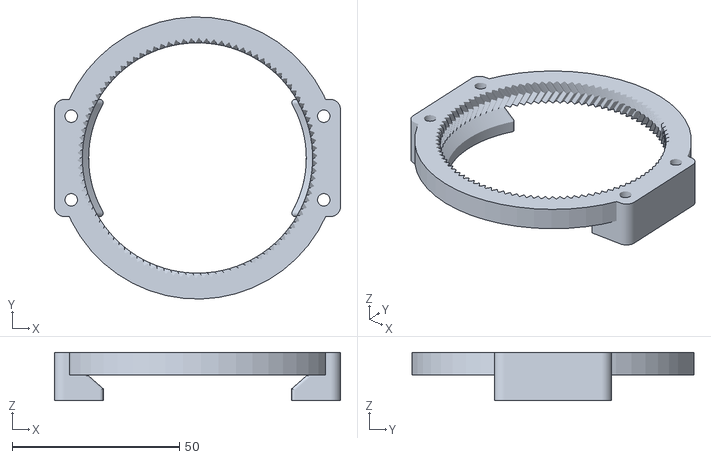
[picture p81: CAD file, 2025-12-09]
Semester_Thesis_Tim_Heger_Final/100_Design_and_models/lower_segment/print2-turning/printing/gear_ring_v2.stl
85.4 x 84.2 x 14.4
