Friedsam2000/Robotic-Arm-Prototype/Semester_Thesis_Tim_Heger_Final/100_Design_and_models/upper_segment/printing/tentioner_tube.stl

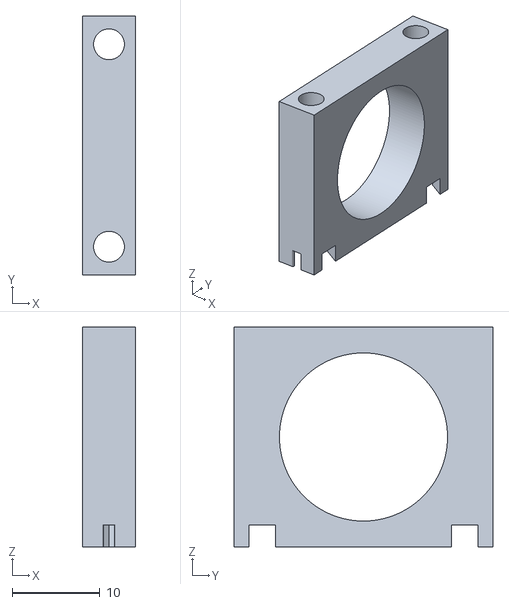
[picture p82: CAD file, 2025-12-09]
Semester_Thesis_Tim_Heger_Final/100_Design_and_models/upper_segment/printing/tentioner_tube.stl
6.00 x 29.4 x 25.0
