Friedsam2000/Robotic-Arm-Prototype/Master_Thesis_Samuel_Zeitler_Final/CAD/shoulder_parts/printing/gear_motor.stl

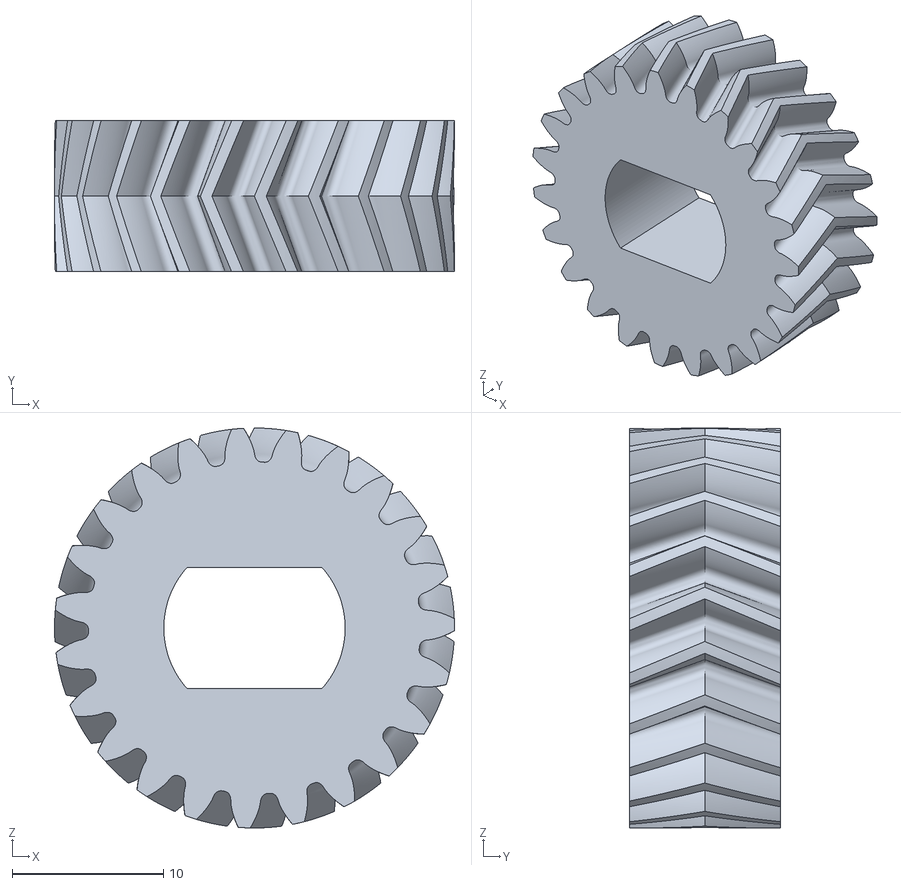
[picture p83: CAD file, 2025-12-09]
Master_Thesis_Samuel_Zeitler_Final/CAD/shoulder_parts/printing/gear_motor.stl
26.5 x 10.0 x 26.5
