Friedsam2000/Robotic-Arm-Prototype/Semester_Thesis_Tim_Heger_Final/100_Design_and_models/lower_segment/print2-turning/printing/side_brace_torque_wheel.stl

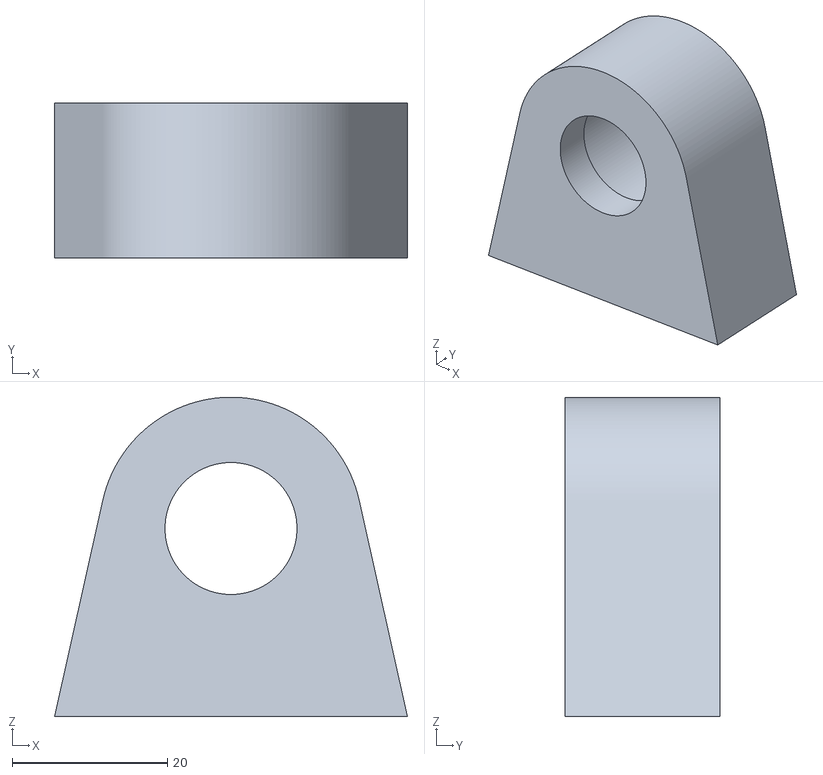
[picture p85: CAD file, 2025-12-09]
Semester_Thesis_Tim_Heger_Final/100_Design_and_models/lower_segment/print2-turning/printing/side_brace_torque_wheel.stl
45.5 x 20.0 x 41.2
