Friedsam2000/Robotic-Arm-Prototype/Semester_Thesis_Tim_Heger_Final/100_Design_and_models/lower_segment/print3-milling/printing/usb_connector_brace.stl

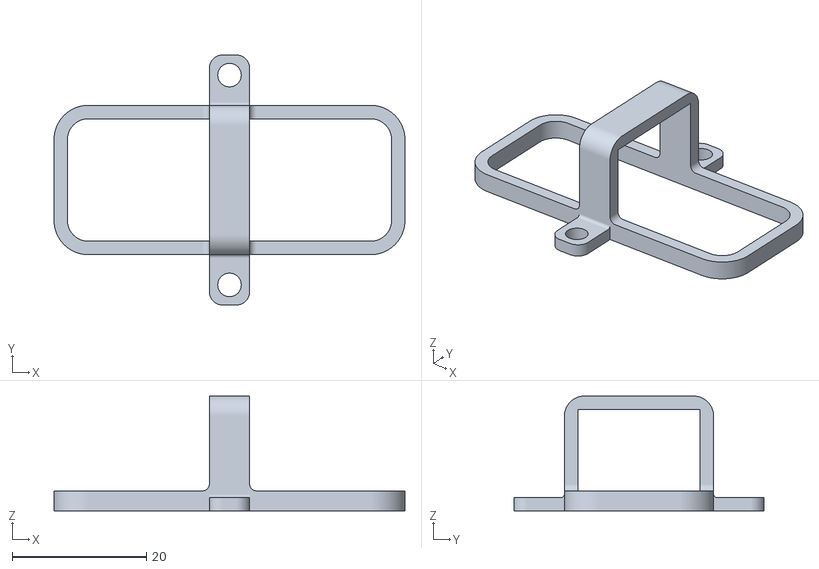
[picture p86: CAD file, 2025-12-09]
Semester_Thesis_Tim_Heger_Final/100_Design_and_models/lower_segment/print3-milling/printing/usb_connector_brace.stl
52.2 x 37.2 x 17.1
