Friedsam2000/Robotic-Arm-Prototype/Semester_Thesis_Tim_Heger_Final/100_Design_and_models/lower_segment/print4/ball_bearing_brace.stl

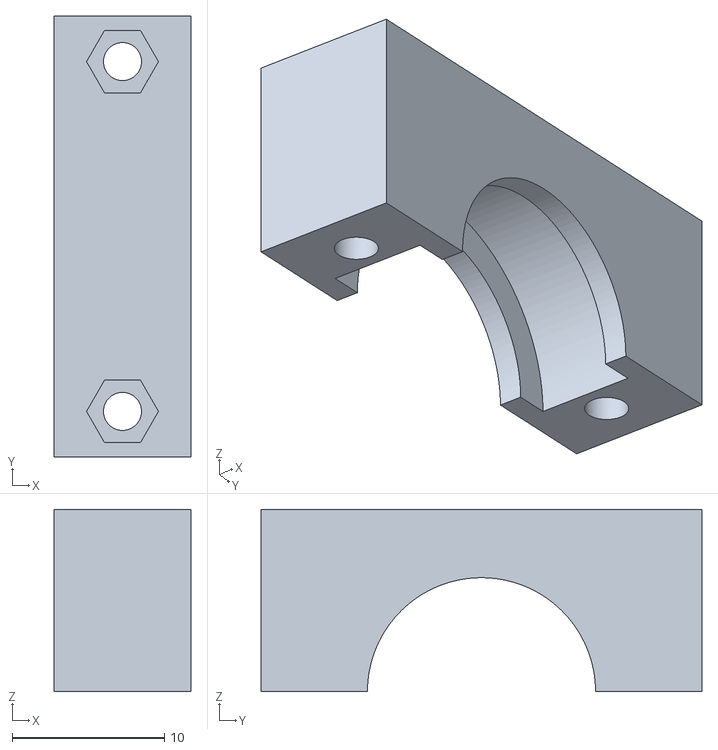
[picture p87: CAD file, 2025-12-09]
Semester_Thesis_Tim_Heger_Final/100_Design_and_models/lower_segment/print4/ball_bearing_brace.stl
9.00 x 29.0 x 12.0
