Friedsam2000/Robotic-Arm-Prototype/Semester_Thesis_Tim_Heger_Final/100_Design_and_models/upper_segment/printing/upper_segment_base_clamp.stl

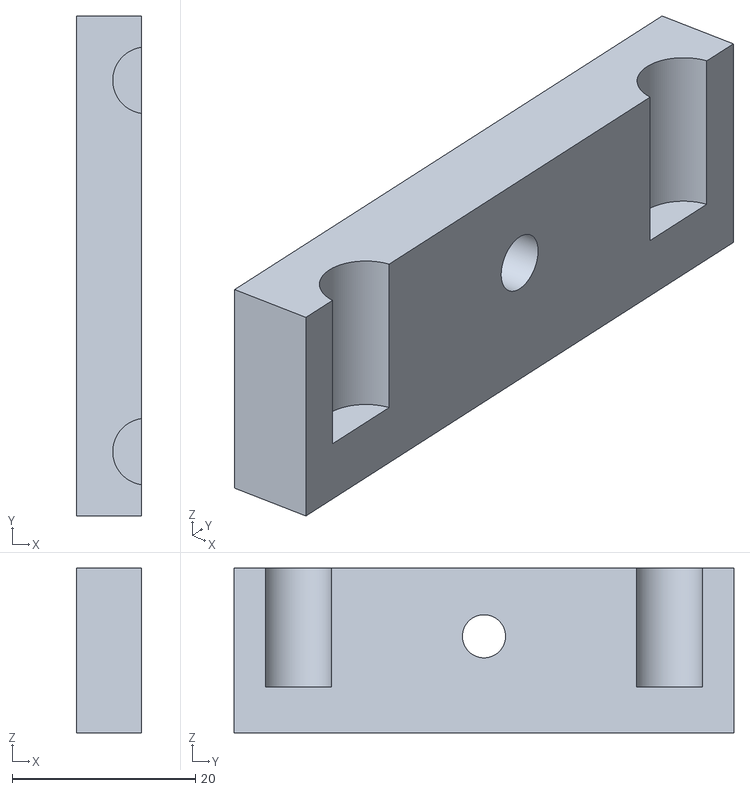
[picture p88: CAD file, 2025-12-09]
Semester_Thesis_Tim_Heger_Final/100_Design_and_models/upper_segment/printing/upper_segment_base_clamp.stl
7.10 x 54.5 x 18.0
