Friedsam2000/Robotic-Arm-Prototype/Master_Thesis_Samuel_Zeitler_Final/CAD/shoulder_parts/printing/bevel_mount_fixed.stl

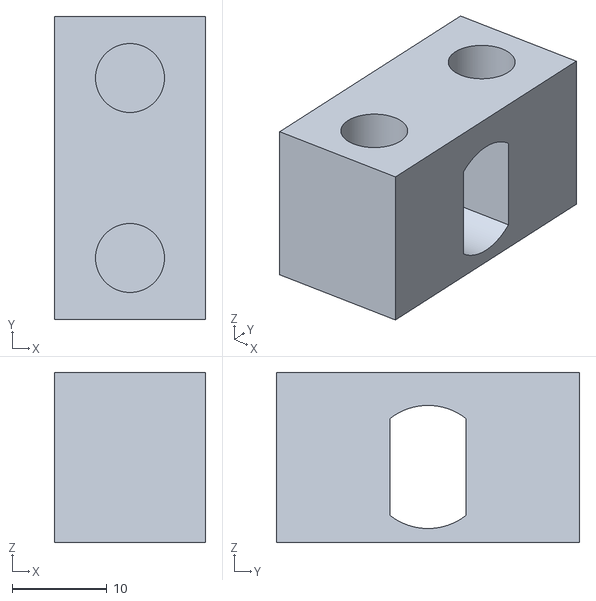
[picture p89: CAD file, 2025-05-14]
Master_Thesis_Samuel_Zeitler_Final/CAD/shoulder_parts/printing/bevel_mount_fixed.stl
16.0 x 32.0 x 18.0
