Friedsam2000/Robotic-Arm-Prototype/Master_Thesis_Samuel_Zeitler_Final/CAD/shoulder_parts/printing/bevel_gear_with_bearings.stl

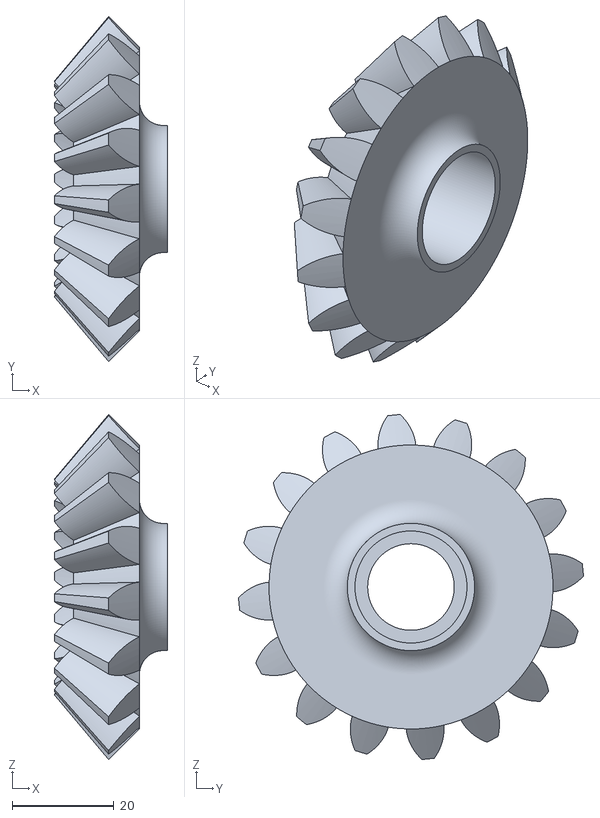
[picture p91: CAD file, 2025-05-14]
Master_Thesis_Samuel_Zeitler_Final/CAD/shoulder_parts/printing/bevel_gear_with_bearings.stl
22.2 x 67.8 x 67.8
