Friedsam2000/Robotic-Arm-Prototype/Semester_Thesis_Tim_Heger_Final/100_Design_and_models/ground_segment/printing/spacing_ring.stl

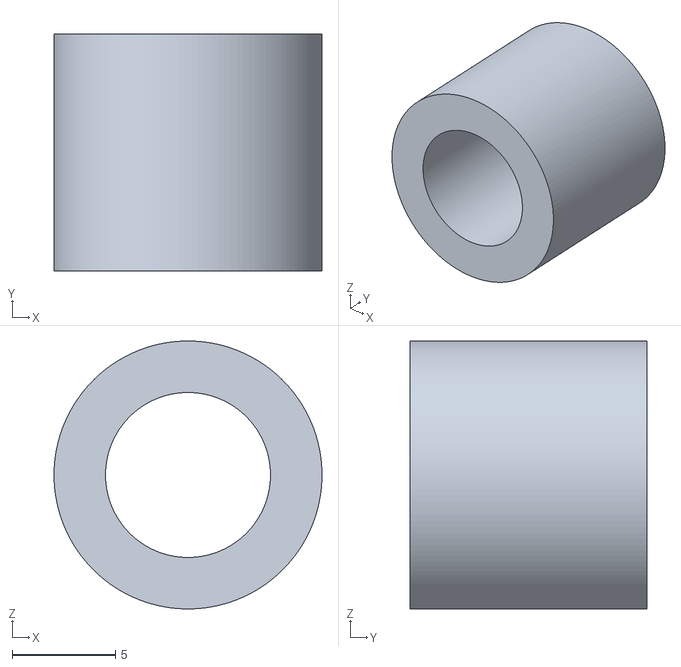
[picture p92: CAD file, 2025-05-14]
Semester_Thesis_Tim_Heger_Final/100_Design_and_models/ground_segment/printing/spacing_ring.stl
13.0 x 11.5 x 13.0
