Friedsam2000/Robotic-Arm-Prototype/Master_Thesis_Samuel_Zeitler_Final/CAD/shoulder_parts/printing/bevel_gear.stl

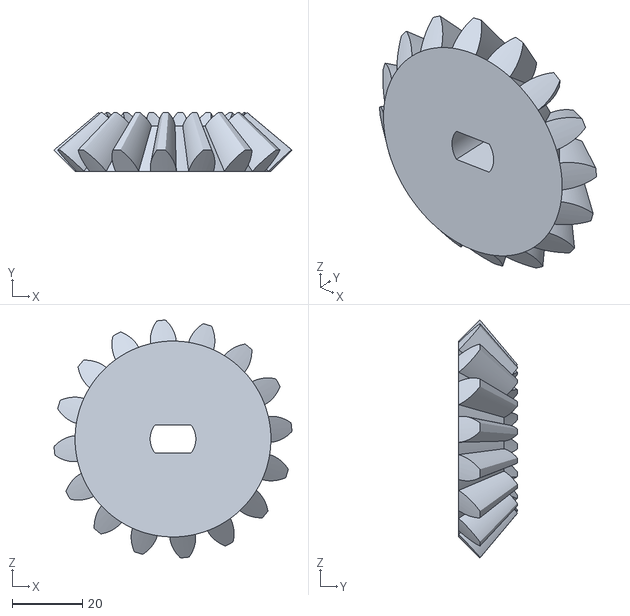
[picture p95: CAD file, 2025-05-14]
Master_Thesis_Samuel_Zeitler_Final/CAD/shoulder_parts/printing/bevel_gear.stl
67.8 x 16.7 x 67.8
