Friedsam2000/Robotic-Arm-Prototype/Master_Thesis_Samuel_Zeitler_Final/CAD/shoulder_parts/printing/spacing_ring_bevel_bearing.stl

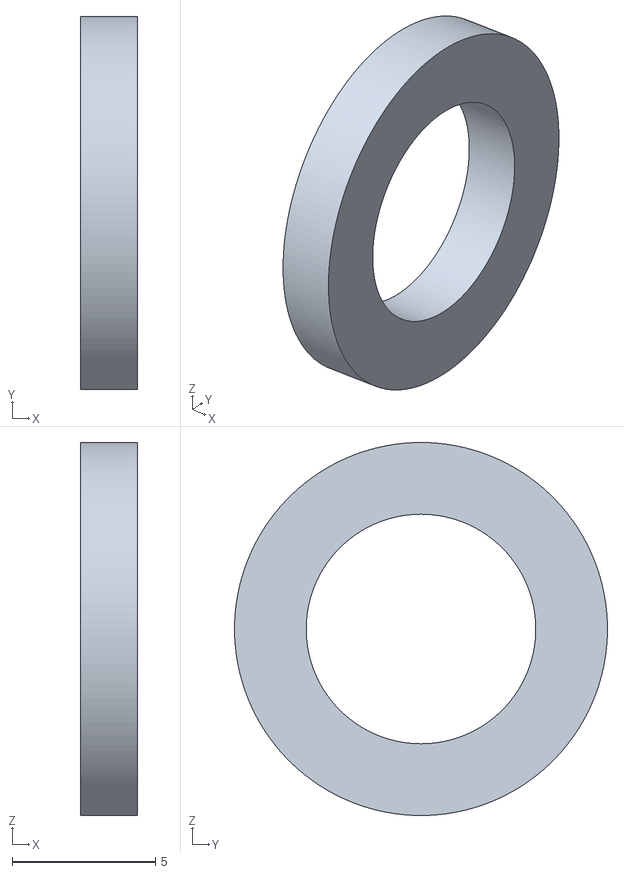
[picture p99: CAD file, 2025-05-14]
Master_Thesis_Samuel_Zeitler_Final/CAD/shoulder_parts/printing/spacing_ring_bevel_bearing.stl
2.00 x 13.0 x 13.0
