Friedsam2000/Robotic-Arm-Prototype/Semester_Thesis_Tim_Heger_Final/100_Design_and_models/upper_segment/printing/tensioner_tube_holder.stl

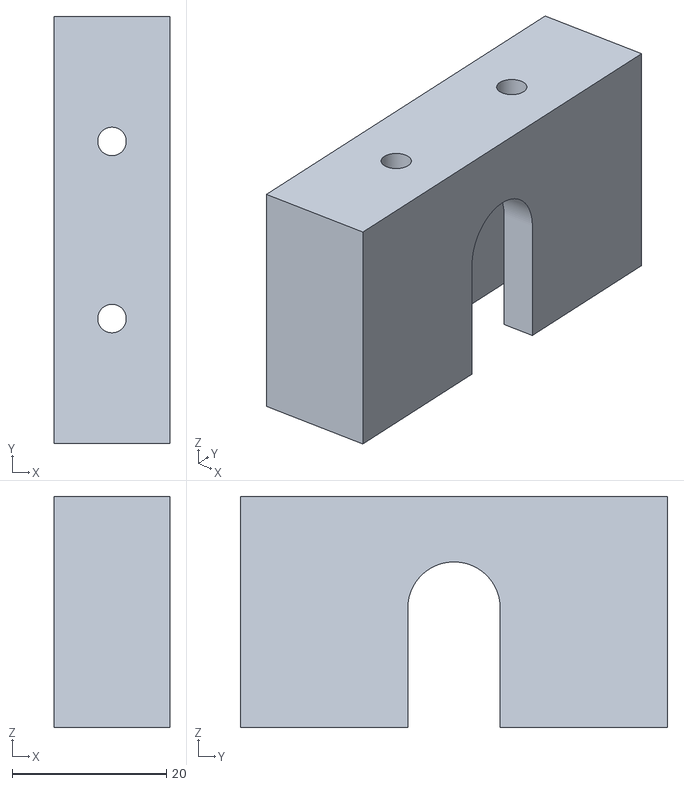
[picture p102: CAD file, 2025-12-09]
Semester_Thesis_Tim_Heger_Final/100_Design_and_models/upper_segment/printing/tensioner_tube_holder.stl
15.0 x 55.5 x 30.0
