Friedsam2000/Robotic-Arm-Prototype/(list of files, cad)

Other CAD files:
Master_Thesis_Samuel_Zeitler_Final/CAD/RoboticArm_shoulder.step
Semester_Thesis_Tim_Heger_Final/100_Design_and_models/lower_segment/print3-milling/printing/bevel_mount.stl
Semester_Thesis_Tim_Heger_Final/100_Design_and_models/upper_segment/printing/tube_endeffector2.stl
Semester_Thesis_Tim_Heger_Final/100_Design_and_models/backups/RoboticArm_shoulder.step
Semester_Thesis_Tim_Heger_Final/100_Design_and_models/backups/TorqueExperiment_290725.step
Semester_Thesis_Tim_Heger_Final/100_Design_and_models/lower_segment/planetary_gear/planetary_gearbox_v1.stl
Semester_Thesis_Tim_Heger_Final/100_Design_and_models/lower_segment/print4/bevel_mount_fixed_v3.stl
