Friedsam2000/Robotic-Arm-Prototype/Master_Thesis_Samuel_Zeitler_Final/Cura_Profiles_for_3D_Printing/Printing_Notees.txt

All parts have been printed on a Creality Ender 3 S1 Pro. ~(350 €)

All parts have been printed using PETG Filament.

Ensure Layer Orientation is perpendicular to operational force.

Contact samuelzeitler2000@gmail.com for questions!
