Friedsam2000/Robotic-Arm-Prototype/Semester_Thesis_Tim_Heger_Final/030_Expose/setup/titlepage.tex

\begin{titlepage}
  \begin{center}
    \vspace*{-1cm}
    \resizebox{!}{1 cm}{%
      \begin{tikzpicture}
        \node[inner sep = 0 pt, outer sep = 0, text width = 10 cm, align = left] at (0, 0) %
        {%
          \fontfamily{phv}\selectfont\color{tum blue}%
          Chair of Automatic Control\\
          Department of Mechanical Engineering\\
          Technical University of Munich
        };
      \end{tikzpicture}
    }
    \hfill
    \resizebox{!}{1 cm}{%
      \begin{tikzpicture}
        \path[fill=tum blue]
        (0.1649, 0.8021) -- (0.0000, 0.8021) --
        (0.0000, 1.0000) -- (0.7347, 1.0000) --
        (0.7347, 0.2028) -- (0.9109, 0.2028) --
        (0.9109, 1.0000) -- (1.8716, 1.0000) --
        (1.8716, 0.0000) -- (1.6653, 0.0000) --
        (1.6653, 0.7930) -- (1.4884, 0.7930) --
        (1.4884, 0.0000) -- (1.2842, 0.0000) --
        (1.2842, 0.7930) -- (1.1098, 0.7930) --
        (1.1098, 0.0000) -- (0.5326, 0.0000) --
        (0.5326, 0.8021) -- (0.3642, 0.8021) --
        (0.3642, 0.0000) -- (0.1663, 0.0000) --
        cycle;
      \end{tikzpicture}
    }
    
    \vspace*{1.5cm}
    
    {\Large\bfseries\sffamily%
      Exposé for a Doctoral Project
    }
  
    \vspace{0.7cm}
    
    {\large\itshape 
      Provisional Title:
    }
    
    \vspace{0.1cm}
    
    {\LARGE \bfseries\sffamily
      Discrete-Time Geometric Modeling and Control of\\[0.3em]
      Flexible Robot Manipulators in Industrial Application
    }% in Industrial Application}
  
    \vspace{0.5cm}
    
    {\large
      Maximilian Herrmann
      
      \vspace{0.3cm}
      
      \today
    }
  
  \end{center}
  \vspace{0.2cm}
\end{titlepage}
