Friedsam2000/Robotic-Arm-Prototype/Semester_Thesis_Tim_Heger_Final/900_Report/setup/metadata.tex

% Edit this file to configure the title page and PDF metadata

\def\thesisAuthor{Tim Heger}
\def\thesisTitleDE{Entwicklung und Verbesserung eines Leichtbau-Roboterarms mit Schwerpunkt auf Drehmomentregelung}
\def\thesisSubtitleDE{}

\def\thesisTitleEN{Development and Enhancement of a Lightweight Robotic Arm with Torque Control Exploration}
\def\thesisSubtitleEN{}

%%% Thesis types (comment out/ uncomment the correct one or make your own edits)

% English:
\def\thesisType{Thesis Submitted in Partial Fulfillment of the Requirements for the Degree of\newline Master of Science}
%\def\thesisType{Thesis Submitted in Partial Fulfillment of the Requirements for the Degree of\newline Bachelor of Science}
%\def\thesisType{IDP}
%\def\thesisType{Term paper}

% German:
%\def\thesisType{Wissenschaftliche Arbeit zur Erlangung des Grades Master of Science}
%\def\thesisType{Wissenschaftliche Arbeit zur Erlangung des Grades Bachelor of Science}
%\def\thesisType{IDP}
%\def\thesisType{Semesterarbeit}

%%% Your thesis _submission_ date
\def\thesisDateEN{3. November 2025}
\def\thesisDateDE{3.\ November 2025}

%%% Names of your supervisors / advisors
% * If your supervisor / advisor is in the list below => just uncomment their name
% * If your supervisor / advisor is not on the list: Please be careful with titles:
%    * pre-nominal titles go _before_ the name:
%       * Dipl.-Ing.\ Max Mustermann
%       * Dr.\,rer.\,nat.\ Max Mustermann
%       * PD Dr.\ Max Mustermann
%    * post-nominal titles go _after_ the name:
%       * Jane Doe, B.Sc.
%       * Jane Doe, M.Sc.
%       * Jane Doe, Ph.D.

\def\thesisSupervisors{%
	Prof.\ Dr.-Ing.\ habil.\ Boris Lohmann
   %PD\ Dr.-Ing.\ habil.\ Paul Kotyczka
}
\def\thesisAdvisors{%
Samuel Zeitler, M.Sc.
%  Felix Anhalt, M.Sc.
%  Joscha Bongard, M.Sc.
%  Maximilian Herrmann, M.Sc.
%  Ahmed Ismail, M.Sc.
%  Phillip Pitschi, M.Sc.
%  Matthias Rowold, M.Sc.
%  Johannes Schwarz, M.Sc.
%  Tobias Thoma, M.Sc.
%  Levent Ögretmen, M.Sc.
%  Prof.\ Dr.-Ing.\ habil.\ Boris Lohmann
%  PD\ Dr.-Ing.\ habil.\ Paul Kotyczka
}

\def\titlePageLogo{logo-none}
