Friedsam2000/Robotic-Arm-Prototype/Semester_Thesis_Tim_Heger_Final/900_Report/setup/packages.tex

\makeatletter
\@ifundefined{c@chapter}{
  \newcounter{chapter}
  \renewcommand{\thechapter}{\thesection}
}{}
\makeatother

% ======================================================================
% Basic encoding and localisation packages
% ======================================================================
\usepackage[T1]{fontenc}
\usepackage{babel}
\usepackage{iflang}
% ======================================================================

% ======================================================================
% Fonts and symbols
% ======================================================================
\usepackage[scaled = 0.92]{helvet}
\usepackage{lmodern}
\usepackage{mathrsfs} % Adds \mathscr{}
% ======================================================================

% ======================================================================
% TikZ and PGF tools
% ======================================================================
\usepackage{tikz,pgfplots}
\usepackage{tikzscale} 
\usetikzlibrary{decorations.pathreplacing}
\usetikzlibrary{shapes,arrows,patterns}

\usepackage[siunitx, european]{circuitikz}

\pgfplotsset{compat=newest}
\usepackage{pgfkeys}

% For MATLAB2TIKZ
\newlength\figureheight
\newlength\figurewidth
% ======================================================================

%% ======================================================================
%% ToDo Notes
%% ======================================================================
\usepackage[colorinlistoftodos,prependcaption]{todonotes}

\newcommand{\todoX}[1]{\todo[linecolor=tum dia red,backgroundcolor=tum dia red!25,bordercolor=tum dia red,inline]{#1}}
\newcommand{\todoY}[1]{\todo[linecolor=tum blue,backgroundcolor=tum blue!25,bordercolor=tum blue,inline]{#1}}
\newcommand{\todoZ}[1]{\todo[linecolor=tum green,backgroundcolor=tum green!25,bordercolor=tum green,inline]{#1}}

% ======================================================================
% Page layout, fine typography and fancy things
% ======================================================================
\usepackage{empheq}
\usepackage{pdflscape}
\usepackage{enumerate}
\usepackage{fancyhdr}
\usepackage[headheight = 14 pt]{geometry}
\usepackage{setspace}
\usepackage{csquotes}
%\usepackage{framed}
% ======================================================================

% ======================================================================
% Graphics, figures etc.
% ======================================================================
\usepackage{graphicx}
\usepackage{import} %for importing pdf_tex-files
\usepackage{pdfpages}

%\usepackage{floatflt}
\usepackage[font=small]{subfig}
%\usepackage[list = true, hypcap = true]{subcaption}
\usepackage{caption}
\usepackage{epstopdf}
%\usepackage{emp} % Encapsulated METAPOST, used for UML diagrams
% ======================================================================

% ======================================================================
% Math packages
% ======================================================================
\usepackage{amssymb}
\usepackage{amsthm}
\usepackage{amsmath}
\usepackage{siunitx}
\usepackage{xfrac}
\usepackage{cancel}
\usepackage{bm}
% ======================================================================

% ======================================================================
% Tables
% ======================================================================
%\usepackage{longtable}
%\usepackage{threeparttable}
\usepackage{multirow}
\usepackage{makecell}
%\usepackage{tabularx}
%\usepackage{booktabs}
%\usepackage{colortbl}
%\usepackage{multicol}
% ======================================================================

% ======================================================================
% Bibliography, glossary, acronyms
% ======================================================================
\usepackage[style=numeric]{biblatex}
\usepackage{acro}
\usepackage{thmtools}
% ======================================================================

% ======================================================================
% Listings and algorithms
% ======================================================================
\usepackage{listings}
\usepackage[ruled, vlined, linesnumbered, algochapter]{algorithm2e}
%\usepackage{algorithm}
%\usepackage{algpseudocode}
% ======================================================================

% ======================================================================
% Hyperref (always goes at the end)
% ======================================================================
\usepackage{hyperref}
\usepackage[capitalise]{cleveref} % must be loaded after hyperref
% ======================================================================
