Friedsam2000/Robotic-Arm-Prototype/Semester_Thesis_Tim_Heger_Final/100_Design_and_models/visualisation/torque_experiment_setup2.png

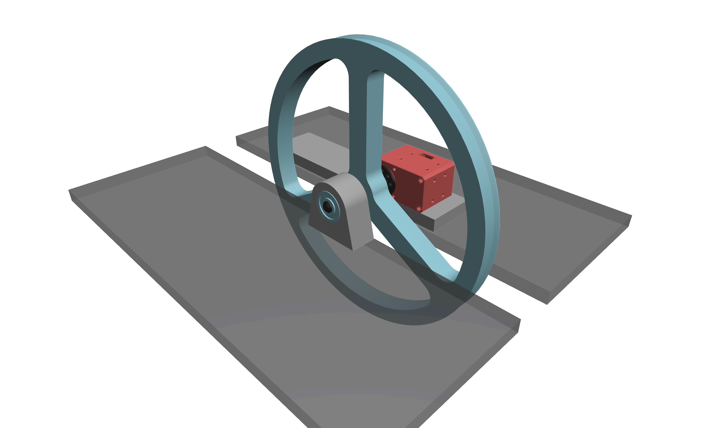
Semester_Thesis_Tim_Heger_Final/100_Design_and_models/visualisation/torque_experiment_setup2.png
