Friedsam2000/Robotic-Arm-Prototype/Semester_Thesis_Tim_Heger_Final/300_Experiments/README.md

`300_Experiments` here is the description of your experiments and the measurement results
