Friedsam2000/Robotic-Arm-Prototype/Semester_Thesis_Tim_Heger_Final/300_Experiments/ExperimentResults/Experiment2_lifting_weight/ccw-25-07-03-T115759.csv

time | currents servo1
0 | 0
0.031519 | 0
0.1434228 | 99.53
0.2550897 | 182.92
0.3671153 | 287.83
0.4791861 | 387.36
0.5907146 | 478.82
0.7029231 | 554.14
0.8310286 | 648.29
0.9590725 | 731.68
1.071272 | 680.57
1.182843 | 650.98
1.295127 | 613.32
1.40688 | 680.57
1.519115 | 718.23
1.647068 | 661.74
1.775084 | 632.15
1.90292 | 710.16
2.03082 | 664.43
2.142763 | 618.7
2.255055 | 645.6
2.36668 | 731.68
2.494581 | 656.36
2.606889 | 624.08
2.718693 | 675.19
2.83057 | 699.4
2.942707 | 680.57
3.054794 | 642.91
3.167334 | 704.78
3.278872 | 669.81
3.39063 | 667.12
3.502748 | 640.22
3.614971 | 688.64
3.726745 | 672.5
3.83899 | 659.05
3.950873 | 653.67
4.062837 | 726.3
4.174773 | 685.95
4.286739 | 653.67
4.415031 | 667.12
4.526988 | 761.27
4.638783 | 677.88
4.766932 | 642.91
4.896414 | 726.3
5.006737 | 661.74
5.134777 | 656.36
5.262856 | 648.29
5.374412 | 659.05
5.486686 | 688.64
5.614743 | 645.6
5.726803 | 672.5
5.838451 | 696.71
5.950646 | 677.88
6.062727 | 634.84
6.174644 | 659.05
6.30284 | 688.64
6.430346 | 723.61
6.558354 | 634.84
6.670278 | 728.99
6.782406 | 672.5
6.894585 | 704.78
7.006595 | 645.6
7.118537 | 699.4
7.230502 | 699.4
7.342523 | 683.26
7.454465 | 642.91
7.566175 | 675.19
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
