Friedsam2000/Robotic-Arm-Prototype/Semester_Thesis_Tim_Heger_Final/300_Experiments/ExperimentResults/Experiment2_lifting_weight/ccw-25-07-03-T123600.csv

time | currents servo1
0 | 0
0.0316764 | 0
0.143599 | 13.45
0.2557117 | 13.45
0.3675502 | 13.45
0.4957 | 10.76
0.6236348 | 13.45
0.7355419 | 10.76
0.8479851 | 10.76
0.9595984 | 10.76
1.071673 | 10.76
1.199623 | 10.76
1.327458 | 29.59
1.455618 | 177.54
1.567513 | 328.18
1.679581 | 419.64
1.7923 | 521.86
1.903619 | 581.04
2.015572 | 659.05
2.127649 | 720.92
2.23959 | 664.43
2.351586 | 648.29
2.463831 | 640.22
2.575547 | 704.78
2.687425 | 683.26
2.799422 | 656.36
2.927465 | 642.91
3.05546 | 685.95
3.183455 | 661.74
3.295249 | 632.15
3.40733 | 672.5
3.519521 | 707.47
3.631445 | 653.67
3.743547 | 618.7
3.855544 | 694.02
3.967516 | 696.71
4.079371 | 664.43
4.207382 | 637.53
4.351916 | 699.4
4.479412 | 720.92
4.607282 | 618.7
4.719284 | 661.74
4.831515 | 704.78
4.95941 | 648.29
5.088263 | 602.56
5.215222 | 739.75
5.32745 | 696.71
5.44005 | 640.22
5.551937 | 667.12
5.6641 | 772.03
5.775623 | 656.36
5.903541 | 626.77
6.031861 | 704.78
6.159947 | 667.12
6.287964 | 675.19
6.399399 | 645.6
6.527756 | 710.16
6.639828 | 715.54
6.751812 | 642.91
6.863777 | 672.5
6.975349 | 731.68
7.087163 | 661.74
7.21514 | 634.84
7.343148 | 723.61
7.471197 | 683.26
7.599252 | 667.12
7.711379 | 642.91
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
