Friedsam2000/Robotic-Arm-Prototype/Semester_Thesis_Tim_Heger_Final/300_Experiments/ExperimentResults/Experiment1_first_readings/ccw-2.csv

time | currents servo1
0 | 0
0.0324988 | 0
0.1599909 | 18.83
0.2720777 | 13.45
0.3998524 | 13.45
0.5128403 | 16.14
0.6236218 | 13.45
0.7357846 | 16.14
0.8476776 | 13.45
0.9597673 | 13.45
1.08781 | 13.45
1.215572 | 13.45
1.343572 | 13.45
1.455556 | 13.45
1.583675 | 13.45
1.6955 | 13.45
1.823443 | 13.45
1.951567 | 13.45
2.079417 | 13.45
2.19139 | 10.76
2.303409 | 13.45
2.415344 | 13.45
2.527442 | 13.45
2.639369 | 13.45
2.767372 | 10.76
2.879344 | 13.45
2.991372 | 13.45
3.119528 | 13.45
3.231481 | 13.45
3.343383 | 10.76
3.471329 | 13.45
3.583448 | 10.76
3.711341 | 10.76
3.823676 | 10.76
3.93558 | 10.76
4.06352 | 10.76
4.175712 | 10.76
4.303399 | 10.76
4.431588 | 13.45
4.55955 | 13.45
4.687616 | 10.76
4.799615 | 10.76
4.911685 | 10.76
5.039493 | 10.76
5.167609 | 10.76
5.27941 | 75.32
5.391353 | 158.71
5.503337 | 228.65
5.615256 | 279.76
5.727407 | 376.6
5.855469 | 468.06
5.983316 | 538
6.111357 | 581.04
6.239076 | 659.05
6.351225 | 691.33
6.463245 | 734.37
6.57515 | 683.26
6.687082 | 702.09
6.799217 | 661.74
6.911392 | 688.64
7.023155 | 763.96
7.151135 | 710.16
7.279318 | 680.57
7.407005 | 694.02
7.535319 | 629.46
7.64699 | 750.51
7.759248 | 667.12
7.871293 | 715.54
7.983282 | 696.71
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
