Friedsam2000/Robotic-Arm-Prototype/Semester_Thesis_Tim_Heger_Final/300_Experiments/ExperimentResults/Experiment1_first_readings/ccw-3.csv

time | currents servo1
0 | 0
0.0500194 | 0
0.1741366 | 16.14
0.3021653 | 16.14
0.4140701 | 13.45
0.5260351 | 13.45
0.6380629 | 13.45
0.7500883 | 13.45
0.8620609 | 13.45
0.9740943 | 13.45
1.102138 | 13.45
1.230071 | 13.45
1.341983 | 10.76
1.454057 | 10.76
1.566016 | 8.07
1.678045 | 10.76
1.805869 | 10.76
1.934067 | 10.76
2.04601 | 10.76
2.158025 | 13.45
2.286088 | 10.76
2.39794 | 8.07
2.509928 | 10.76
2.637954 | 86.08
2.76584 | 215.2
2.877884 | 336.25
2.989757 | 468.06
3.10173 | 564.9
3.213741 | 664.43
3.325804 | 691.33
3.45375 | 648.29
3.581636 | 669.81
3.709701 | 637.53
3.821742 | 685.95
3.933938 | 696.71
4.045619 | 659.05
4.157941 | 632.15
4.269616 | 696.71
4.381657 | 726.3
4.493833 | 645.6
4.621838 | 667.12
4.749922 | 707.47
4.877889 | 648.29
5.005635 | 624.08
5.117704 | 683.26
5.229794 | 688.64
5.341657 | 680.57
5.453648 | 613.32
5.565645 | 694.02
5.677714 | 669.81
5.789783 | 664.43
5.901641 | 621.39
6.013529 | 726.3
6.125621 | 718.23
6.253658 | 648.29
6.381847 | 653.67
6.50954 | 675.19
6.637672 | 650.98
6.749495 | 621.39
6.861589 | 650.98
6.973669 | 675.19
7.085686 | 677.88
7.197673 | 645.6
7.309617 | 688.64
7.421707 | 656.36
7.53373 | 677.88
7.645517 | 629.46
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
