Friedsam2000/Robotic-Arm-Prototype/Semester_Thesis_Tim_Heger_Final/300_Experiments/ExperimentResults/Experiment1_first_readings/ccw-4.csv

time | currents servo1
0 | 0
0.0320631 | 0
0.1438286 | 16.14
0.2560922 | 16.14
0.3677711 | 18.83
0.4961086 | 18.83
0.6236479 | 16.14
0.751885 | 16.14
0.8799285 | 16.14
0.9918583 | 13.45
1.103716 | 16.14
1.21536 | 13.45
1.327624 | 13.45
1.439596 | 16.14
1.551637 | 13.45
1.679483 | 16.14
1.807653 | 16.14
1.919619 | 13.45
2.031512 | 16.14
2.159457 | 13.45
2.271741 | 13.45
2.383631 | 13.45
2.495606 | 13.45
2.607401 | 13.45
2.7195 | 13.45
2.847357 | 13.45
2.975555 | 10.76
3.08741 | 10.76
3.199508 | 10.76
3.311561 | 10.76
3.423476 | 13.45
3.535547 | 34.97
3.663263 | 242.1
3.775292 | 408.88
3.88734 | 543.38
3.999297 | 669.81
4.12724 | 710.16
4.255284 | 677.88
4.38335 | 640.22
4.511323 | 664.43
4.623464 | 672.5
4.735415 | 621.39
4.847671 | 696.71
4.959384 | 685.95
5.071415 | 626.77
5.183445 | 707.47
5.311282 | 694.02
5.439156 | 645.6
5.551431 | 699.4
5.663155 | 669.81
5.791108 | 653.67
5.903059 | 675.19
6.015191 | 677.88
6.127477 | 642.91
6.255331 | 702.09
6.36737 | 634.84
6.495144 | 642.91
6.606995 | 734.37
6.719071 | 621.39
6.847219 | 675.19
6.975432 | 667.12
7.103365 | 640.22
7.215399 | 672.5
7.327134 | 688.64
7.439375 | 637.53
7.567318 | 696.71
7.695208 | 659.05
7.823264 | 648.29
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
