Friedsam2000/Robotic-Arm-Prototype/Semester_Thesis_Tim_Heger_Final/300_Experiments/ExperimentResults/Experiment1_first_readings/ccw-5.csv

time | currents servo1
0 | 0
0.031413 | 0
0.1593251 | 21.52
0.2712417 | 21.52
0.383466 | 21.52
0.4960901 | 21.52
0.6073481 | 18.83
0.7192096 | 21.52
0.8314293 | 18.83
0.9594207 | 34.97
1.087388 | 24.21
1.199334 | 18.83
1.327247 | 16.14
1.455209 | 16.14
1.567316 | 18.83
1.679269 | 21.52
1.807254 | 18.83
1.935333 | 16.14
2.063258 | 16.14
2.191314 | 18.83
2.303242 | 13.45
2.415275 | 16.14
2.527322 | 18.83
2.639265 | 16.14
2.751152 | 13.45
2.879079 | 13.45
3.006925 | 13.45
3.135092 | 18.83
3.247057 | 13.45
3.375315 | 16.14
3.503245 | 266.31
3.631158 | 454.61
3.759178 | 667.12
3.871047 | 737.06
3.983127 | 653.67
4.095083 | 629.46
4.206793 | 683.26
4.319053 | 624.08
4.446955 | 648.29
4.575037 | 632.15
4.687138 | 650.98
4.815025 | 640.22
4.926947 | 659.05
5.038907 | 659.05
5.15086 | 629.46
5.262738 | 688.64
5.374814 | 629.46
5.486824 | 691.33
5.599039 | 621.39
5.710803 | 656.36
5.822824 | 672.5
5.935035 | 661.74
6.047224 | 675.19
6.158762 | 621.39
6.270975 | 669.81
6.382894 | 640.22
6.494762 | 667.12
6.623059 | 659.05
6.750793 | 669.81
6.878978 | 640.22
7.006955 | 667.12
7.118648 | 672.5
7.231016 | 650.98
7.342732 | 683.26
7.45476 | 632.15
7.566747 | 699.4
7.694827 | 659.05
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
