Friedsam2000/Robotic-Arm-Prototype/Semester_Thesis_Tim_Heger_Final/300_Experiments/ExperimentResults/Experiment3_radial_load/cw-nl-25-07-08-T113337.csv

time | currents servo1
0 | 0
0.0295722 | 0
0.141271 | -18.83
0.252717 | -18.83
0.365327 | -18.83
0.476729 | -21.52
0.58892 | -21.52
0.700986 | -21.52
0.813043 | -24.21
0.925084 | -24.21
1.03654 | -21.52
1.14928 | -21.52
1.26109 | -24.21
1.37307 | -24.21
1.48499 | -21.52
1.59704 | -24.21
1.70895 | -24.21
1.83673 | -24.21
1.96473 | -24.21
2.09264 | -24.21
2.22102 | -24.21
2.34926 | -24.21
2.4771 | -26.9
2.60491 | -24.21
2.73255 | -24.21
2.86084 | -26.9
2.98886 | -26.9
3.11663 | -24.21
3.2283 | -24.21
3.34048 | -24.21
3.45225 | -21.52
3.56452 | -24.21
3.67628 | -24.21
3.80427 | -24.21
3.93248 | -21.52
4.06029 | -24.21
4.18867 | -21.52
4.30052 | -21.52
4.41257 | -24.21
4.52496 | -24.21
4.63666 | -21.52
4.7489 | -21.52
4.8769 | -24.21
4.98899 | -24.21
5.10019 | -21.52
5.21242 | -21.52
5.32476 | -24.21
5.4523 | -21.52
5.5649 | -18.83
5.67686 | -21.52
5.78842 | -21.52
5.91651 | -18.83
6.0449 | -21.52
6.15633 | -18.83
6.26848 | -18.83
6.38052 | -16.14
6.49255 | -18.83
6.60447 | -18.83
6.71636 | -16.14
6.8444 | -16.14
6.97234 | -18.83
7.10016 | -16.14
7.22848 | -16.14
7.34025 | -18.83
7.45242 | -16.14
7.58068 | -16.14
7.70839 | -18.83
7.83656 | -16.14
7.94841 | -16.14
8.06044 | -16.14
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
