Friedsam2000/Robotic-Arm-Prototype/Semester_Thesis_Tim_Heger_Final/300_Experiments/ExperimentResults/Experiment3_radial_load/cw-nl-25-07-08-T113415.csv

time | currents servo1
0 | 0
0.0318283 | 0
0.144099 | -21.52
0.256043 | -18.83
0.367911 | -21.52
0.480022 | -21.52
0.591766 | -21.52
0.703894 | -21.52
0.816049 | -21.52
0.928155 | -21.52
1.04025 | -21.52
1.15161 | -24.21
1.26445 | -24.21
1.37607 | -21.52
1.48789 | -24.21
1.59981 | -24.21
1.71167 | -24.21
1.82377 | -24.21
1.93611 | -24.21
2.0484 | -26.9
2.15997 | -24.21
2.27199 | -24.21
2.38407 | -26.9
2.49564 | -26.9
2.60749 | -24.21
2.71983 | -24.21
2.83186 | -24.21
2.94395 | -24.21
3.05579 | -24.21
3.16803 | -24.21
3.27962 | -24.21
3.39176 | -21.52
3.50399 | -21.52
3.61558 | -24.21
3.72792 | -21.52
3.83962 | -21.52
3.95179 | -24.21
4.06403 | -24.21
4.17561 | -24.21
4.28797 | -21.52
4.39947 | -24.21
4.51142 | -21.52
4.62345 | -21.52
4.7362 | -21.52
4.84847 | -21.52
4.95967 | -18.83
5.07195 | -18.83
5.1994 | -21.52
5.32751 | -21.52
5.45567 | -18.83
5.5837 | -18.83
5.71178 | -18.83
5.83996 | -16.14
5.96785 | -16.14
6.09589 | -18.83
6.22396 | -16.14
6.35177 | -16.14
6.47943 | -18.83
6.60808 | -16.14
6.73538 | -18.83
6.86338 | -18.83
6.99131 | -16.14
7.11998 | -16.14
7.24732 | -16.14
7.37545 | -16.14
7.50358 | -16.14
7.63129 | -16.14
7.75948 | -16.14
7.8879 | -16.14
8.01577 | -16.14
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
