Friedsam2000/Robotic-Arm-Prototype/Master_Thesis_Samuel_Zeitler_Final/CAD/shoulder_parts/turning/Bevel_Shaft.pdf

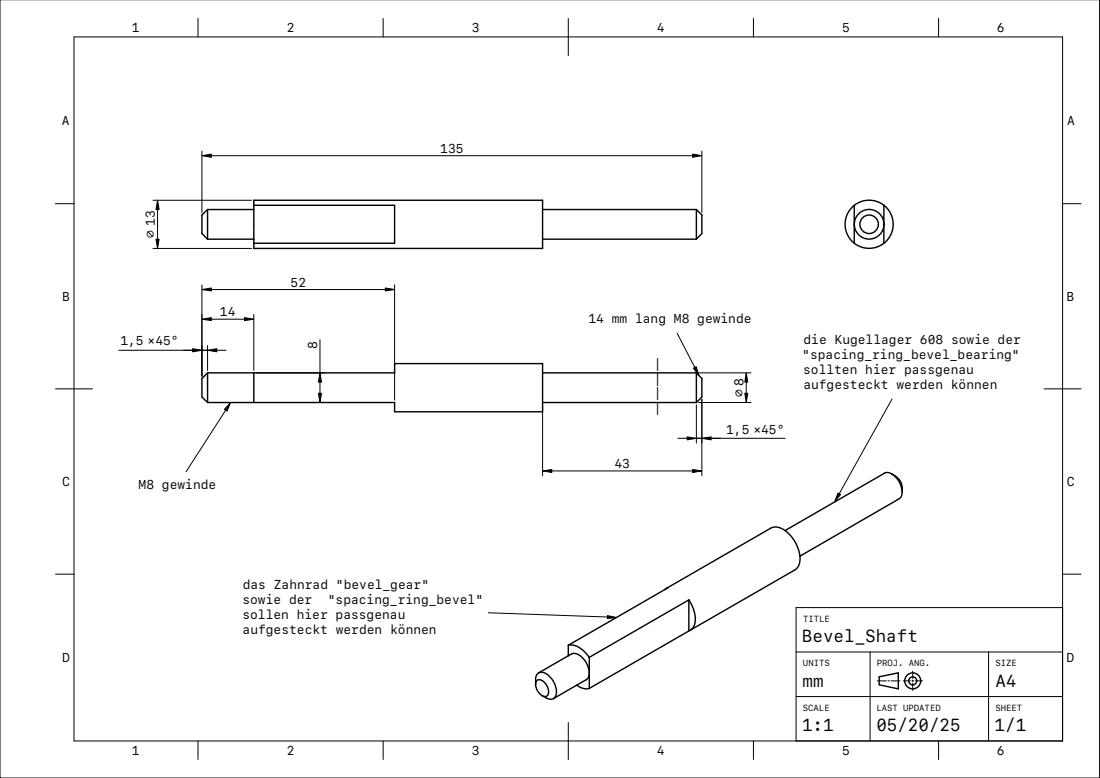
[picture p105: page 1]
TITLE Bevel_Shaft; M8 gewinde

14 mm lang M8 gewinde

die Kugellager 608 sowie der
"spacing_ring_bevel_bearing"
sollten hier passgenau
aufgesteckt werden können

das Zahnrad "bevel_gear"
sowie der "spacing_ring_bevel"
sollen hier passgenau

UNITS mm | PROJ. ANG. | SIZE A4

SCALE 1:1 | LAST UPDATED 05/20/25 | SHEET 1/1
