Friedsam2000/Robotic-Arm-Prototype/Master_Thesis_Samuel_Zeitler_Final/CAD/shoulder_parts/turning/Motor_Shaft.pdf

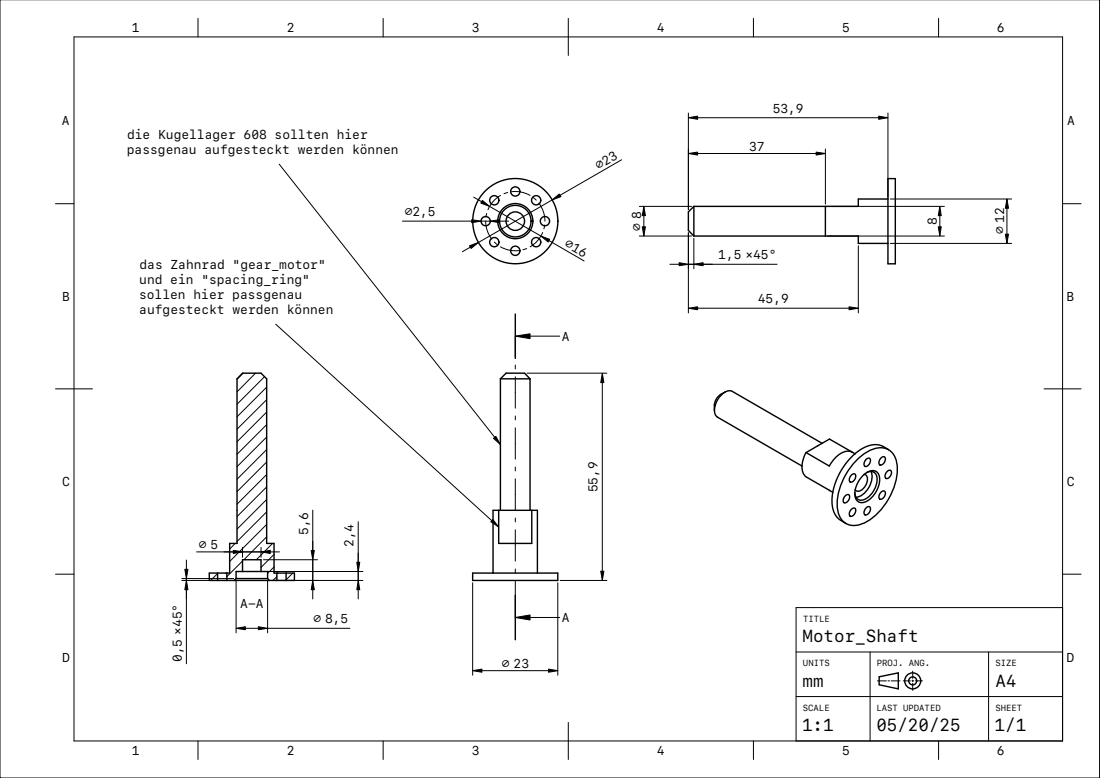
[picture p107: page 1]
TITLE Motor_Shaft

die Kugellager 608 sollten hier
passgenau aufgesteckt werden können

das Zahnrad "gear_motor"
und ein "spacing_ring"
sollen hier passgenau
aufgesteckt werden können

UNITS mm | PROJ. ANG. | SIZE A4

SCALE 1:1 | LAST UPDATED 05/20/25 | SHEET 1/1
