Friedsam2000/Robotic-Arm-Prototype/Semester_Thesis_Tim_Heger_Final/100_Design_and_models/ground_segment/milling/Side_Lid.pdf

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

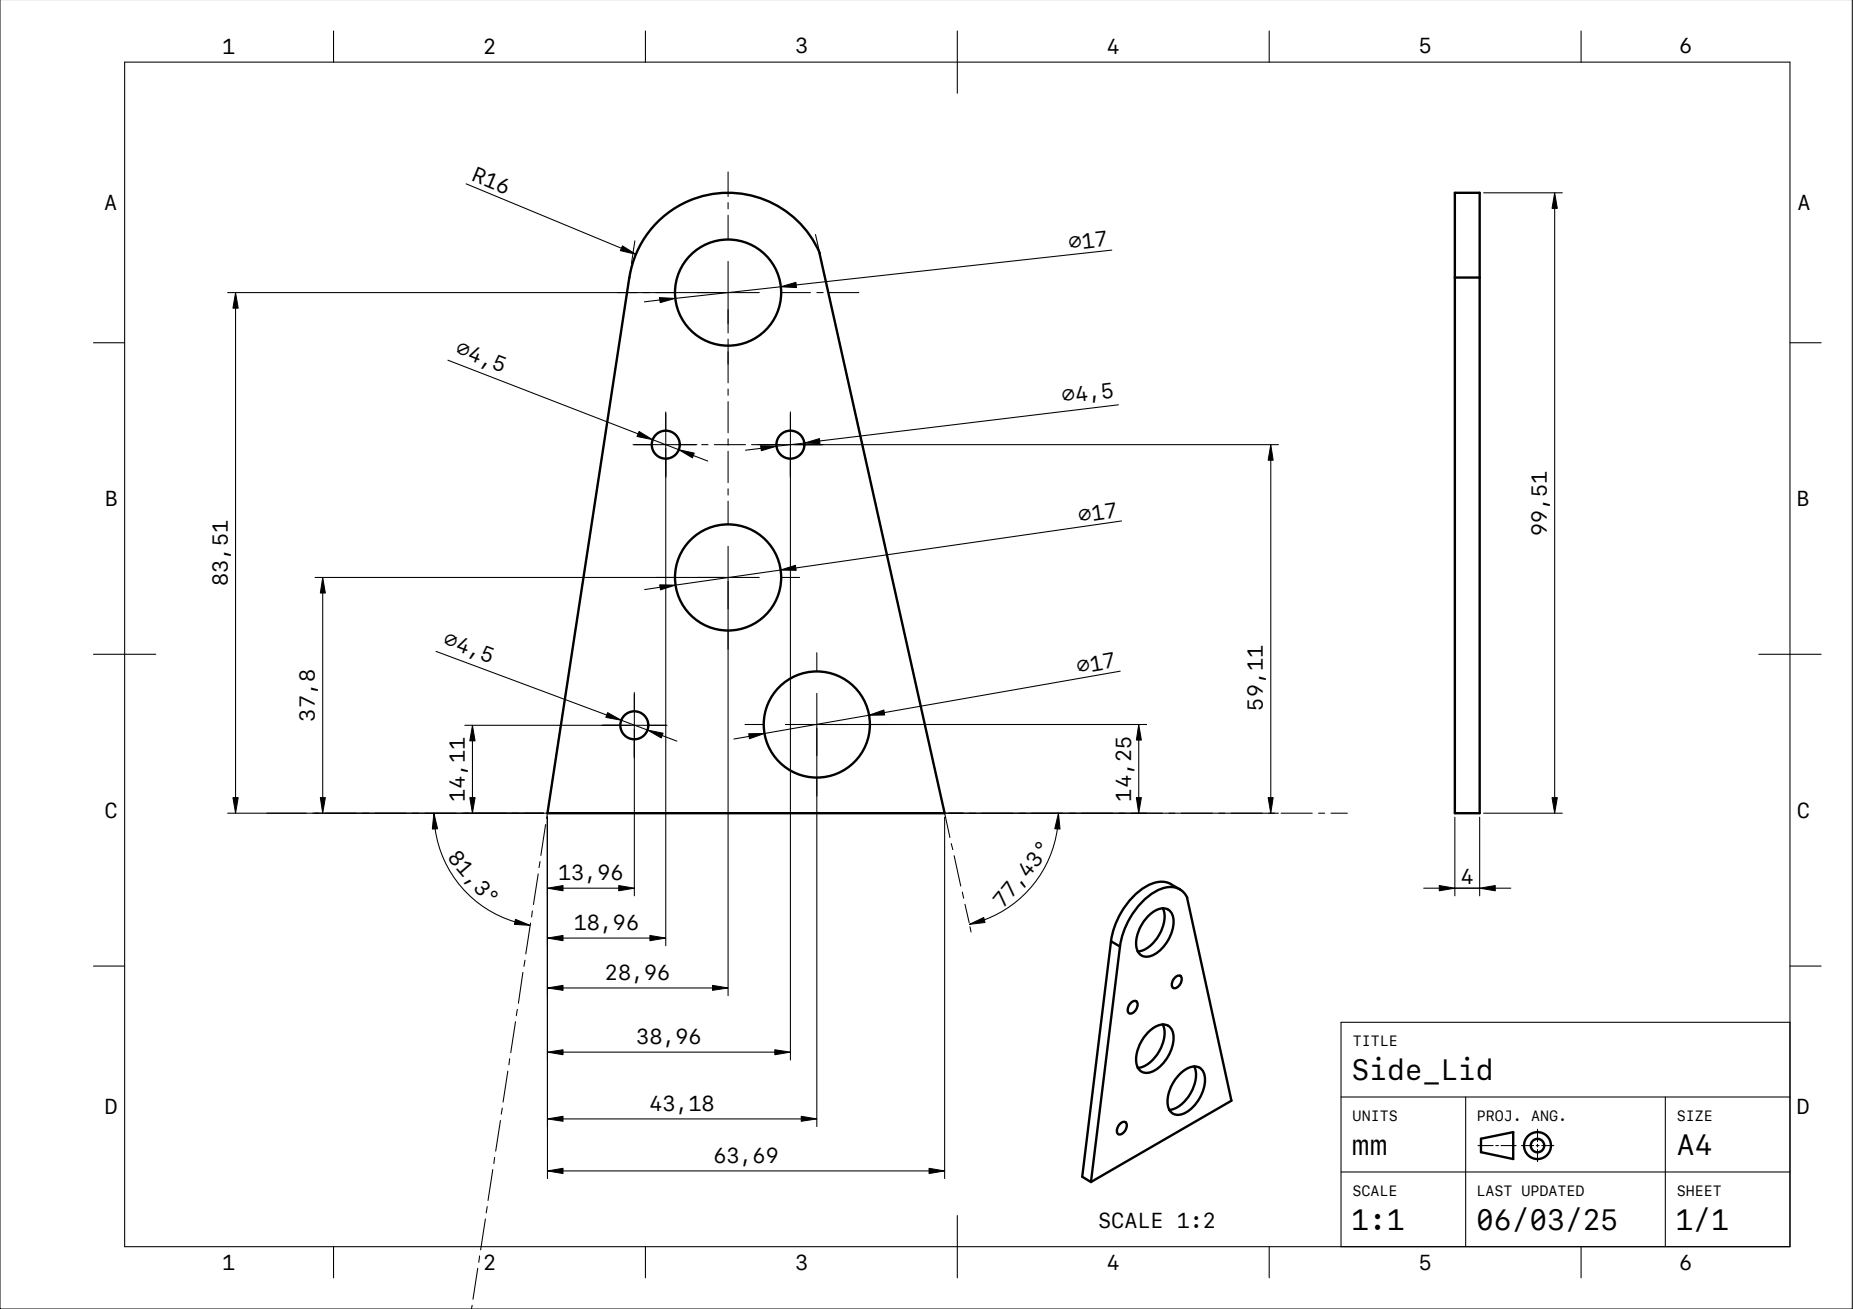
[picture p114: page 1]
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
