Friedsam2000/Robotic-Arm-Prototype/Semester_Thesis_Tim_Heger_Final/100_Design_and_models/upper_segment/turning/endeffector_shaft.pdf

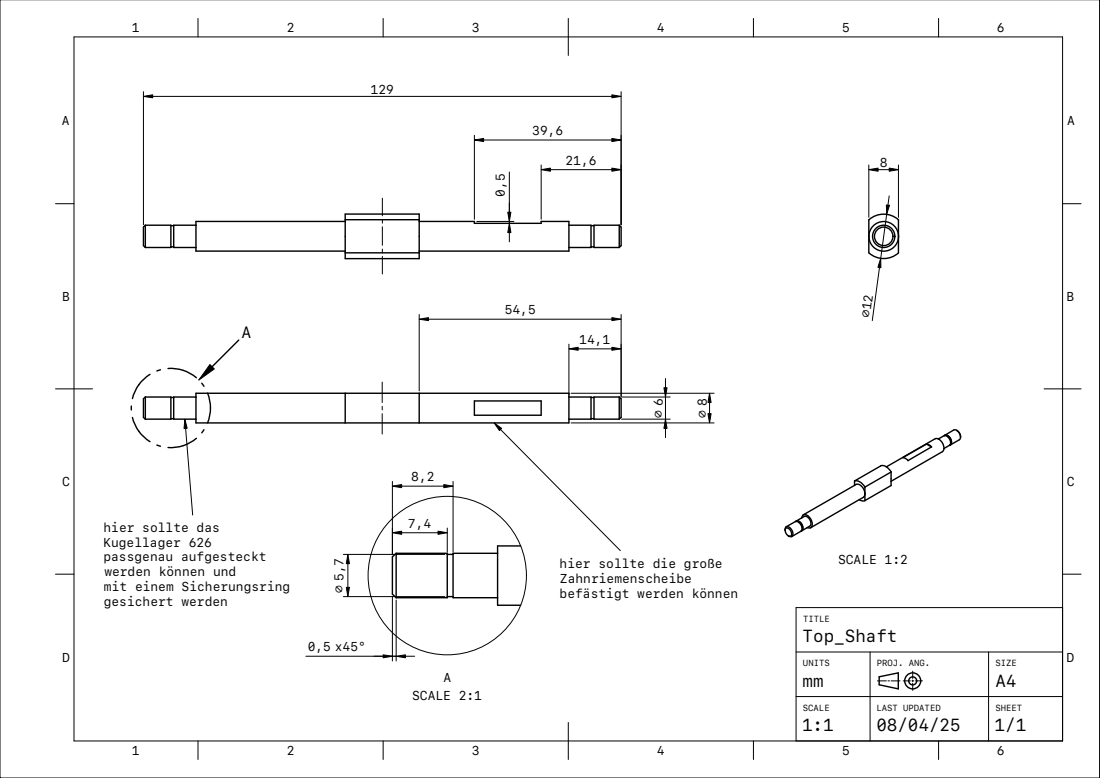
[picture p116: page 1]
A SCALE 2:1; SCALE 1:2; TITLE Top_Shaft

hier sollte das
Kugellager 626
passgenau aufgesteckt
werden können und
mit einem Sicherungsring
gesichert werden

hier sollte die große
Zahnriemenscheibe
befästigt werden können

UNITS mm | PROJ. ANG. | SIZE A4

SCALE 1:1 | LAST UPDATED 08/04/25 | SHEET 1/1
