Friedsam2000/Robotic-Arm-Prototype/Semester_Thesis_Tim_Heger_Final/100_Design_and_models/lower_segment/print2-turning/turning/Motor_Axis.pdf

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

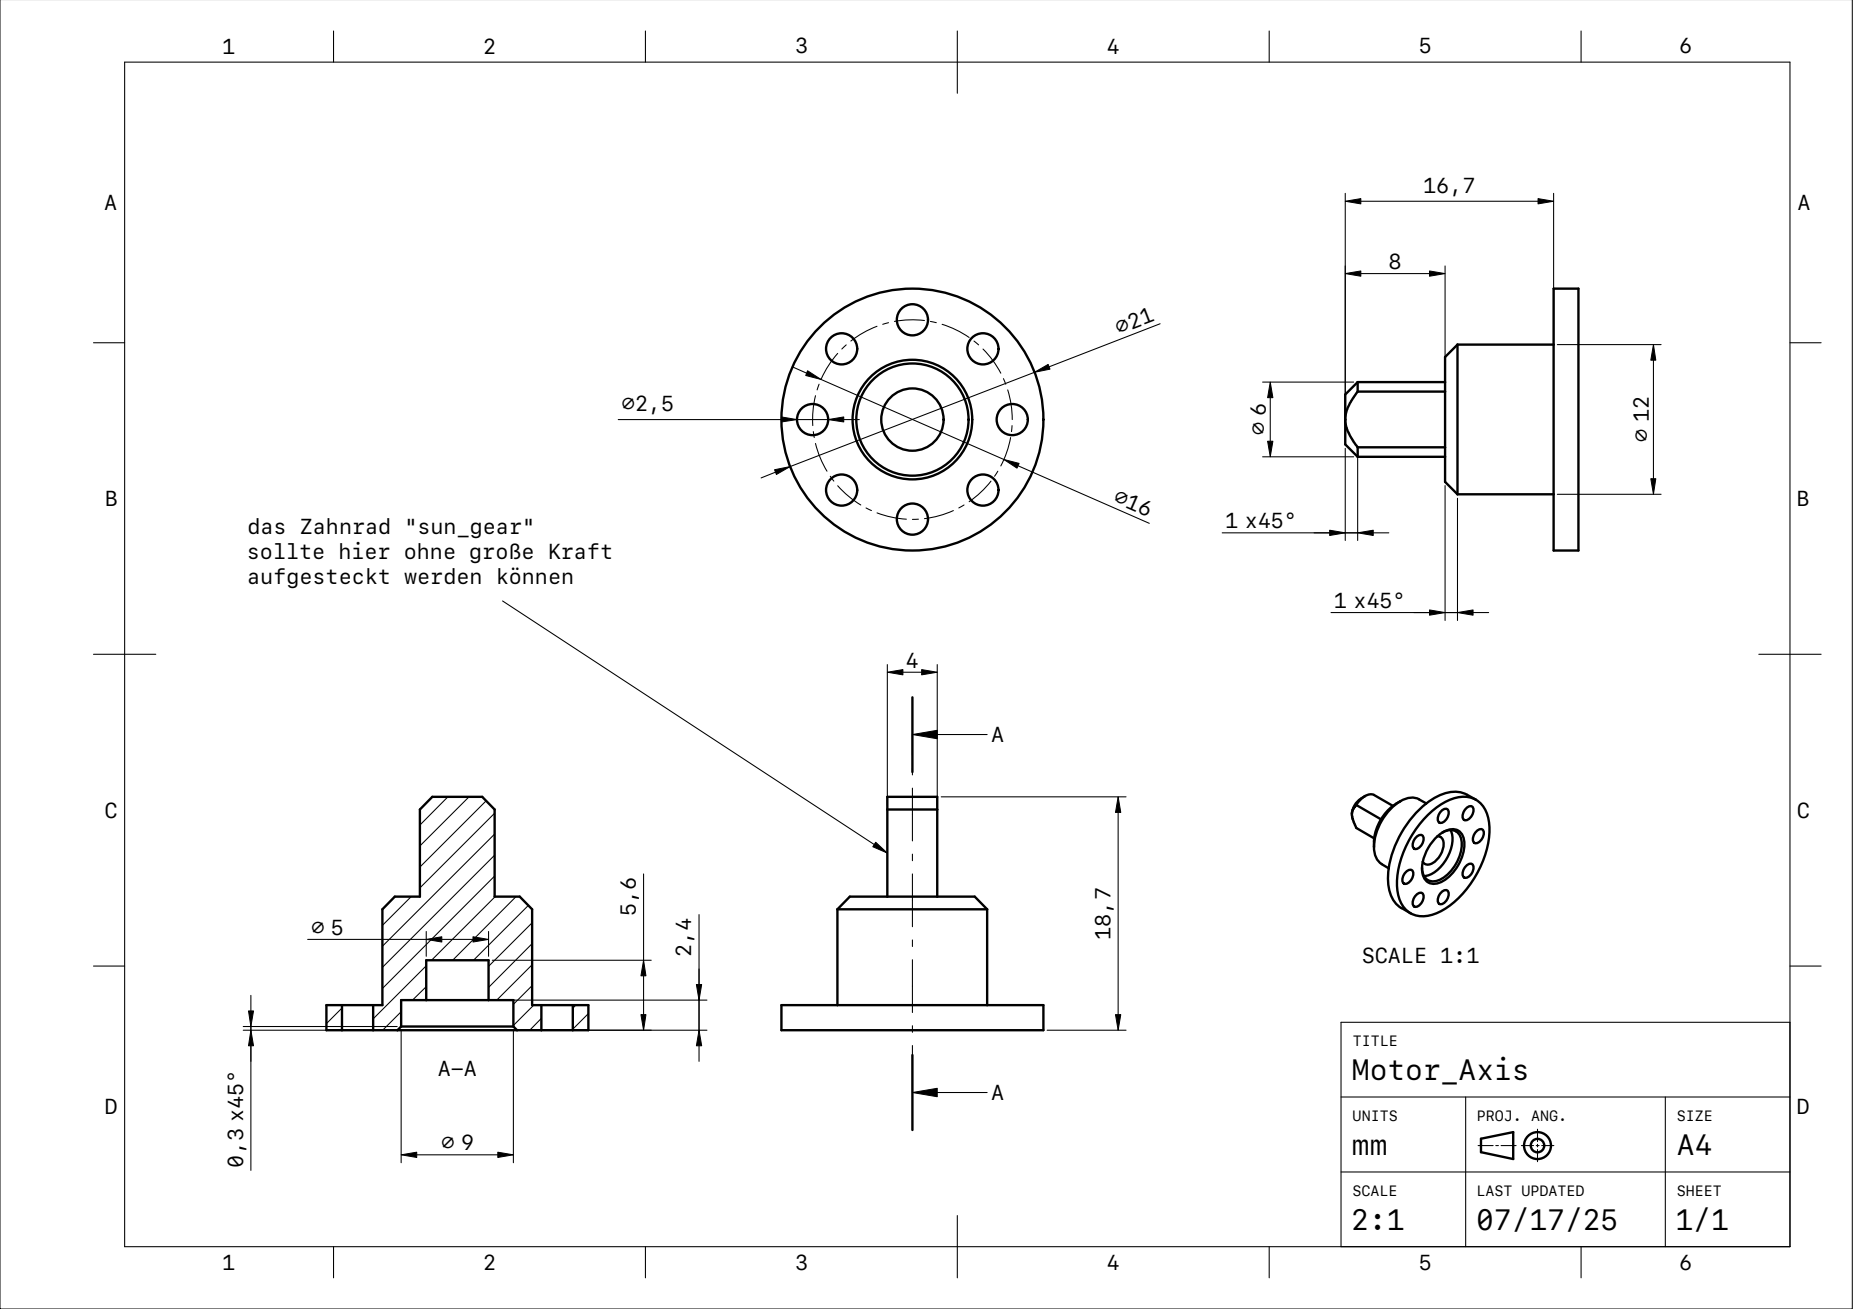
[picture p118: page 1]
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
