Friedsam2000/Robotic-Arm-Prototype/(commit log)

2024-01-05 todo button für programme in app
2024-01-08 need to fix drawing of figures virtual robot and then frames
2024-01-08 Abort Button: Next Up Singularity Handling
2024-01-11 torque switch working fine
2024-01-11 pause for timer deletion
2024-01-11 stop button working
2024-01-13 fixed timer deltion error by moving drawnow
2024-01-14 joint_ angles in deg
2024-01-14 Joint limits for set joints
2024-01-18 reworked receiving and sending in ServoChain
2024-01-25 set servo operation mode and joint 3 pid gains
2024-01-27 only shoulder joint ( revert this when all servos are present)
2024-02-01 Revert "only shoulder joint ( revert this when all servos are present)"
    This reverts commit c2a94c8820ad368177187234f2a9ba6f46ed278e.
2024-02-01 xl430 w250 except yaw joint: xh430 w210
2024-02-18 Added Recordings button, Refactored how the argument checking works. All logic now in program.
2024-04-22 Added CAD Model to Git Repo
2024-04-26 3d printing info
2024-04-27 added belt to cad
2024-04-29 added cad for assembly
2024-05-09 simplified limiting of joint angles in the NullspaceController.m
2024-05-11 removed unused children property of Frame.m
2025-05-14 updated shoulder joint
2025-05-14 added stl files for printing
    [bevel_gear.stl, bevel_gear_with_bearings.stl, bevel_mount.stl, bevel_mount_fixed.stl, spacing_ring.stl, spacing_ring_bevel_bearing.stl]
2025-05-14 updated stl files
2025-05-21 added drawings for turning
    [bevel_shaft.step, middle_shaft.step, motor_shaft.step, top_shaft.step]
2025-05-21 added basic current control functions to ServoChain
2025-12-09 updated stuff from tim
    [Base_Plate.step, Motor_Axis.step, RoboticArm_shoulder.step, Side_Brace.step, Side_Lid.step, TorqueExperiment_290725.step, ball_bearing_brace.stl, bevel_gear.stl]
